Roxywwww/-/实验数据/图片/2026-10-13_HX711排查图片/新HX711实际焊接.jpg

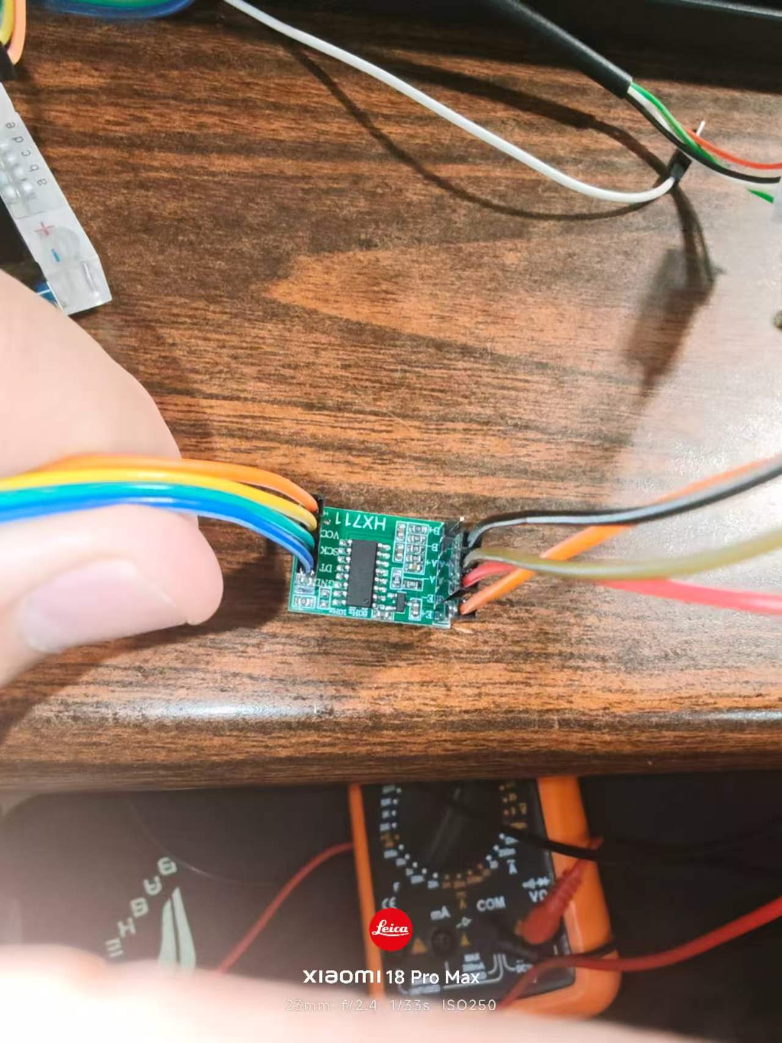
实验数据/图片/2026-10-13_HX711排查图片/新HX711实际焊接.jpg
