Roxywwww/-/实验数据/阶段记录/2026-10-13_20kg传感器与HX711接线排查记录.md

# 20 kg 称重传感器与 HX711 接线排查记录

记录日期：2026-10-13  
用途：毕业设计“硬件调试与故障排查”章节的原始素材。以下是本次实际报告的测量和串口记录；尚未进行去皮、已知质量标定或精度评价。

## 测试背景与初始现象

- 控制器为 STM32F103C8T6；HX711 使用 A 通道、128 倍增益；串口以十进制有符号整数打印 `raw`。
- 本次同时换用了新的 20 kg 称重传感器和 HX711 小板，二者之间有四芯转接头和杜邦线；电压测试时小板 VCC 由 5 V 供电。
- 按商家“10 kg 及以上传感器接线图”，初始连接为白→E+、黑→E−、红→A−、绿→A+。这只是**商家图片标注**，当时尚未验证该只实物的电桥线序。
- 初始空载时串口反复显示 `raw=-8388608`，受力后也没有正常的对应变化。该值是 HX711 有符号 24 位输出的负向极限值，不是质量。

图片证据：[商家接线示意](../图片/2026-10-13_HX711排查图片/商家接线示意.jpg)、[实际焊接](../图片/2026-10-13_HX711排查图片/新HX711实际焊接.jpg)、[四芯转接头](../图片/2026-10-13_HX711排查图片/四芯转接头.jpg)。转接头两侧导线颜色不同，追线时按通断关系确认，不能只看转接线颜色。

## 故障状态下的电压

传感器已连接、未放重物，HX711 小板上电。以下 E+、A+、A− 均以 E− 为黑表笔参考点。

| 测点 | 测量/计算结果 |
|---|---:|
| E− 对 GND | 约 0 V |
| E+ 对 E− | 4.11 V，实测 |
| A− 对 E− | 2.73 V，实测 |
| A+ 对 E− | 1.36 V，实测 |
| A+ 减 A− | −1.37 V，由两次实测计算，非单独实测 |

E+−E− 有 4.11 V 激励，说明并非完全没有传感器供电；A+−A− 却达到约 −1.37 V，远大于正常称重电桥的毫伏级输出，与负向极限 raw 一致。另有 `1.36 V≈4.11 V/3`、`2.73 V≈2×4.11 V/3`，符合把激励加在电桥相邻节点、其余节点处于约 1/3 和 2/3 电位的情况。

## 六组电阻

以下为用户报告的万用表读数。前两组**实际用 20 kΩ 档**，后四组**实际用 2 kΩ 档**；统一换算成 Ω 只是改单位，没有改写测量档位。电阻测量应在断电且传感器与 HX711 分离时进行；本次是否完全断开连接器未单独记录，正式实验应按此条件重测。

| 导线组合 | 原读数 | 换算值 | 实际档位 |
|---|---:|---:|---|
| 白—黑 | 0.24 kΩ | 约 240 Ω | 20 kΩ |
| 红—绿 | 0.29 kΩ | 约 290 Ω | 20 kΩ |
| 白—红 | 0.306 kΩ | 306 Ω | 2 kΩ |
| 白—绿 | 0.343 kΩ | 343 Ω | 2 kΩ |
| 黑—红 | 0.392 kΩ | 392 Ω | 2 kΩ |
| 黑—绿 | 0.257 kΩ | 257 Ω | 2 kΩ |

黑—红与白—绿是互不共线、读数较大的两组。对四臂阻值接近的完整惠斯通电桥，相对节点间的等效电阻通常大于相邻节点间的等效电阻。结合上面的 1/3、2/3 电位关系，推定这只实物更可能以**红—黑为激励对，白—绿为信号对**。实际电桥有修调，电阻不必严格符合四个完全相等电阻的理想模型。

## 接线调整与复测

调试中按红→E+、黑→E−、白→A−、绿→A+ 的目标线序调整转接关系。调整后，串口数据离开负向极限值，空载时约为 3.3 万，受力后升高，卸载后基本恢复。下表从用户发送的连续串口数据中**人工选择稳定段**统计；过渡值未纳入。完整顺序见 [原始串口记录](../原始数据/2026-10-13_20kg传感器接线修正后raw记录.txt)。

| 阶段 | 样本数 | raw 平均值 | 最小值—最大值 | 样本标准差 |
|---|---:|---:|---:|---:|
| 首次空载 | 21 | 33310.5 | 33240—33387 | 37.5 |
| 第一次受力 | 7 | 40502.1 | 40452—40568 | 41.1 |
| 第一次卸载后 | 19 | 33388.5 | 33340—33434 | 30.1 |
| 第二次受力 | 7 | 82118.0 | 82088—82155 | 24.6 |
| 第二次卸载后 | 8 | 33400.3 | 33377—33425 | 15.2 |

两次施力的大小、作用位置和持续时间未记录，不能据此求标定系数、换算克数或评价线性度；恢复值也不与首次空载值完全相同。

## 排查结论与后续补测

故障的直接现象为 HX711 raw 持续处于负向极限。电压测量表明传感器有约 4.11 V 激励，但信号差分约 −1.37 V；六组电阻与 1/3、2/3 电位关系共同提示初始线色分配与实物电桥节点不一致。按推定线序调整后，raw 随施力变化且卸载后基本恢复，完成原始值读取功能验证；**尚未证明质量测量精度**。

正式实验建议补测：①统一在断电、传感器独立状态下用 2 kΩ 档重测六组电阻并记录万用表型号；②量调整后空载 A+−A− 的直流毫伏值；③记录传感器型号、已知质量、安装方式、温度和供电电压；④在相同条件下采集多轮空载/加载/卸载数据。旧 5 kg 传感器数据属于另一套硬件，应单独整理，不与本次 20 kg 数据合并标定。
