Roxywwww/-/实验数据/阶段记录/2026-10-13_20kg传感器空载去皮与串口验证记录.md

# 20 kg 传感器空载去皮与串口验证记录

日期：2026-10-13  
工程：`hx711test`，STM32F103C8T6 + HX711，USART1 115200、8N1  
阶段：原始值稳定读取后的零点去皮；尚未进行质量标定

## 目的与实验条件

在已能读到 HX711 原始值的基础上，验证空载基线，并让程序开机时自动获取去皮零点 `offset`。采集时用户说明秤盘空载。当前机械底盘和最终秤盘结构尚未完成，也没有经其他秤实称的已知质量参考物，因此本次只验证 ADC 计数与去皮，不计算克数或测量精度。

原始串口助手为 COM3，115200、8N1。修改前固件按 `raw=...` 打印十进制有符号 ADC 计数。串口助手接收区取出的连续 120 条数据保存在 [空载原始记录](../原始数据/2026-10-13_空载raw现场采集.txt) 中。软件界面没有提供这些数据的逐条时间戳；固件每次打印后延时 200 ms，但不能据此宣称实际采样间隔严格等于 200 ms。

## 修改内容

仅修改 `hx711test/Core/Src/main.c` 的 `USER CODE` 区域，未改动 CubeMX 自动生成的底层初始化和独立的 HX711 驱动：

1. 上电后先输出 USART1 启动提示，再等待 500 ms。
2. 秤盘保持空载时连续读取 16 次 HX711 转换结果，以其算术平均值作为 `tare_offset`。每次读取仍有 200 ms 的 DOUT 等待超时；遇到超时或 `-8388608`、`8388607` 饱和值，本次去皮判为失败，不使用错误零点。
3. 去皮成功后，串口连续输出 `raw=... net=...`，其中 `net = raw - tare_offset`。`net` 的单位仍是 ADC 计数。去皮失败时保留原始值，并标出 `tare=invalid`。

开机去皮要求秤盘上没有物体；如需重新取零点，可在空载时复位板子。后续按键去皮尚未实现。16 次平均用于减小单次噪声对零点的影响，不等于后续的质量数字滤波。

## 编译与下载

使用 Keil ARMCC V5.06 update 5 编译，结果为 **0 Error(s), 0 Warning(s)**，生成 HEX。通过 Keil/ST-Link 下载，界面显示 `Erase Done`、`Programming Done`、`Verify OK`、`Application running`，Flash Load 完成时间为 21:02:51。串口助手随后显示新格式的 `raw` 与 `net`，说明板上程序运行并持续发出串口数据。

## 数据与结果

| 阶段 | 样本数 | raw 平均值 | raw 最小值～最大值 | 样本标准差 | 备注 |
|---|---:|---:|---:|---:|---|
| 修改前，串口助手接收区末尾空载数据 | 120 | 33295.3 | 33202～33377 | 35.9 | 原始记录见附件 |
| 刷写后，直接读取 COM3 的空载数据 | 50 | 33317.3 | 33267～33397 | 28.7 | 完整记录见附件 |

刷写后的 50 条 `raw,net` 原文保存在 [去皮后串口实测记录](../原始数据/2026-10-13_开机去皮后串口实测.txt) 中，采集完毕后已重新打开串口助手。50 条数据的 `raw - net` 均为 **33283**，据此可核对该次开机的 `tare_offset=33283`。该组 `net` 的平均值为 **+34.3 计数**，范围 **-16～+114 计数**，样本标准差 **28.7 计数**。数据直接来自串口输出，未人工修改或补造。该文件也没有逐条时间戳。

空载 `net` 并非每条都严格为零，因为 `offset` 是开机时 16 次采样的平均值，后续瞬时 ADC 读数会受噪声、机械状态和零点变化影响。前后两组空载数据不是同一时刻采集，不能仅凭它们评估长期零漂或温度影响。

## 可用于论文的阶段性表述

在完成传感器接线排查后，系统通过 STM32F103C8T6 读取 HX711 的 24 位有符号原始数据，并由 USART1 输出。对空载状态下采集的 120 个原始计数进行统计，均值为 33295.3，样本标准差为 35.9。随后在程序中加入开机去皮：对 16 次有效转换结果求平均，作为零点偏移量，再从后续原始计数中减去该偏移量。固件经 Keil 编译无错误、无警告，并通过 ST-Link 下载校验。刷写后连续采集的 50 组串口数据中，`raw-net` 恒为 33283，验证了去皮运算和串口输出的一致性。本阶段尚无已知质量参考物，故数据仅用于验证原始采集与零点处理，不能用于计算克数、标定系数或测量精度。

## 下一步

完成最终机械安装后，在空载条件下重新采集零点；准备至少一件经可信秤称量的已知质量物品，再测得该载荷的稳定 `net`，计算每克 ADC 计数 `scale=(raw_参考-offset)/质量_g`，随后才能使用 `质量_g=net/scale`。继续记录参考物质量、放置位置、加载/卸载次数、原始数据和环境条件，以便评估重复性及误差。
