Roxywwww/-/实验数据/阶段记录/2026-10-15_5点滑动平均滤波开发与实测记录.md

# 5 点滑动平均滤波开发与实测记录

日期：2026-10-15（北京时间）  
工程：`hx711test`，STM32F103C8T6 + HX711，USART1/COM4，115200、8N1  
阶段：完成基本数字滤波；尚未加入 OLED 或温度补偿

## 目的与实现

前一阶段已能经串口输出 `raw/net/g`，但同一载荷下各次 `g` 会随 ADC 噪声和机械状态上下跳动。本次在 [`main.c` 的 USER CODE 区域](../../hx711test/Core/Src/main.c)加入 **5 点滑动平均**，串口保留原有 `raw/net/g`，新增 `g_avg` 以直接比较滤波前后。没有改动 CubeMX 自动生成的初始化、`.ioc` 配置和 HX711 独立驱动；标定系数仍为前一阶段的暂定值 **177.6184 计数/g**。

每次取得有效读数后，先计算 `net = raw - tare_offset`。使用长度为 5 的循环数组存储最近 5 次 `net`，并维护它们的和：新读数加入，数组满时同时扣除被覆盖的旧读数。用和除以当前有效样本数（最初 1～4 次也只除以已有数目），得到 `average_net`，然后按同一系数换算为保留一位小数的 `g_avg`。因此，最初几次不会因为数组初值为零而把显示拉向零。

开机去皮和 PA5 按键去皮成功后均清空滤波状态，以免新的 offset 混入去皮前的旧 `net`。去皮失败不更换 offset，也不清空原滤波状态。主循环约每 200 ms 报告一次，5 个读数约跨越 0.8 s；这是固件报告周期，不代表 HX711 严格等间隔转换。`g_avg` 只是平滑显示，未修改 `raw`、`net` 或瞬时 `g`，也不能消除零点漂移和标定误差。

## 编译与下载

Keil ARMCC V5.06 update 5 编译结果：**0 Error(s), 0 Warning(s)**，生成 HEX；[编译日志](<../构建日志/MDK-ARM/build_filter.log>)。通过 Keil/ST-Link 下载，日志显示 `Erase Done`、`Programming Done`、`Verify OK` 和 `Application running`，完成时间 18:49:33；[下载日志](<../构建日志/MDK-ARM/flash_filter.log>)。随后直接从 COM4 采集到新格式 `raw=... net=... g=... g_avg=...`。

## 实测原始数据与统计

用户确认秤盘空载后下载固件。此后按“空载稳定 → 用户放置标称 500 g → 500 g 稳定 → 连续记录期间用户卸载 500 g → 空载按键去皮”的顺序测量。数据均直接来自 COM4，电脑在收到完整串口行时附上本地时间戳；它不是 ADC 转换时刻。原始记录如下：

1. [空载稳定 100 行 CSV](../原始数据/2026-10-15_5点滑动平均_空载实测.csv)
2. [标称 500 g 稳定 100 行 CSV](../原始数据/2026-10-15_5点滑动平均_500g稳定实测.csv)
3. [500 g 卸载动态 144 行 CSV](../原始数据/2026-10-15_5点滑动平均_500g卸载动态实测.csv)
4. [按键去皮动态串口原文 87 行](../原始数据/2026-10-15_5点滑动平均_按键去皮动态串口原文.txt)

前三份 CSV 的列为 `timestamp_local,raw,net,g,g_avg`。样本标准差使用分母 `n-1`；同一组的两列标准差可比较显示波动，但**不能据此宣称绝对测量精度**。

| 状态与统计段 | 行数 | 瞬时 `g` 均值 | 瞬时 `g` 样本标准差 | `g_avg` 均值 | `g_avg` 样本标准差 | `raw-net` |
|---|---:|---:|---:|---:|---:|---:|
| 空载稳定 | 100 | +0.119 g | 0.156 g | +0.122 g | 0.087 g | 33538 |
| 500 g 稳定 | 100 | 500.672 g | 0.154 g | 500.667 g | 0.087 g | 33538 |
| 卸载动态：前 60 行、尚未卸载 | 60 | 500.677 g | 0.166 g | 500.667 g | 0.122 g | 33538 |
| 卸载动态：最后 50 行、已空载 | 50 | +0.512 g | 0.170 g | +0.518 g | 0.121 g | 33538 |

在两段独立采集的稳定组中，5 点平均后的样本标准差约为瞬时读数的 **56%**，表明这次短时显示波动有所减小。500 g 均值略高于标称值、卸载后空载均值仍约 +0.5 g，提示零点和机械状态在变化；滤波只降低短时抖动，不能代替重新去皮、标定或机械固定。本次 500 g 砝码正是前一阶段用于求系数的标称参考物，不能把此结果当作独立准确度检定。

## 卸载响应与按键去皮

卸载动态 CSV 的第 85 行（电脑接收时间 18:52:16.044）中，瞬时 `g` 已降至 **0.3 g**，而 `g_avg` 仍为 **367.1 g**。第 89 行（18:52:16.850）`g_avg` 才降至 **0.5 g**。按串口接收时间计算，滤波输出比瞬时读数约晚 **0.806 s** 接近空载；这是一次卸载过程的观察，不是完整响应时间指标。动态记录中可由连续 5 行 `net` 独立核对的 140 行，`g_avg` 与固件滑动平均结果全部一致。

用户随后在空载时短按 PA5。串口原文记录到 `tare_button_offset=33589`（18:53:13.336），原 offset 为 33538；去皮后首条输出为 `raw=33590 net=1 g=0.0 g_avg=0.0`。去皮后的 12 条完整读数均满足 `raw-net=33589`，并且以新读数从 1 条累积到最多 5 条计算出的 `g_avg` 与串口一致，验证了按键去皮后滤波窗口清空。串口原文按采集顺序保留。

## 可用于论文的阶段性表述

在已有质量换算程序基础上，引入长度为 5 的滑动平均滤波，以循环数组保存最近 5 次去皮后 ADC 计数，并维护窗口和；每次读取后输出瞬时质量和滤波后质量。空载及标称 500 g 稳定状态各采集 100 组串口数据，瞬时质量的样本标准差分别为 0.156 g、0.154 g，滤波后分别降为 0.087 g、0.087 g。连续记录的卸载过程中，滤波结果比瞬时读数约晚 0.806 s 接近空载，体现了平滑程度与响应速度之间的取舍。按键重新去皮后，滤波窗口清空并使用新零点，串口后续 12 条数据均与重新累计的滑动平均计算一致。本阶段数据来自临时机械安装状态，仅用于验证滤波功能和观察显示波动，不代表全量程精度或温度补偿效果。

## 下一步

先保持 `raw/net/g/g_avg` 并观察日常使用时的响应是否合适；若 0.8 s 左右的卸载延迟影响操作，再在相同条件下比较 3 点等更短窗口。基础滤波验证通过后，才进入 OLED 软件 I2C 显示。最终秤盘及 PCB 安装完成后应重新去皮、标定，再评价系统误差。
