Roxywwww/-/实验数据/阶段记录/2026-10-15_OLED软件I2C移植与称重显示实测记录.md

# OLED 软件 I²C 移植与称重显示实测记录

日期：2026-10-15（北京时间）  
工程：`hx711test`，STM32F103C8T6 + HX711 + 0.96 英寸四针 OLED  
阶段：在已有 `raw → 去皮 → 克数换算 → 五次移动平均` 基础上，增加 OLED 显示

## 参考资料与接线

参考用户提供的 `C:\baidunetdiskdownload\STM32入门教程资料\程序源码\STM32Project-无注释版\4-1 OLED显示屏` 标准库示例，以及 `模块资料\8-OLED显示屏` 中的 OLED 模块资料。示例使用 GPIO 软件模拟 I²C、128×64 OLED、8×16 ASCII 字库；本次保持其 SSD1306 初始化命令、字符写入方法和设备地址字节 `0x78`，将 GPIO 操作换为 HAL API。`0x78` 是包含写方向位的 8 位地址字节，对应 7 位 I²C 地址 `0x3C`。

用户确认模块为 GND/VCC/SCL/SDA 四针，VCC 接 3.3 V，接线按示例：PB8→SCL、PB9→SDA，GND 共地。PB8、PB9 在 CubeMX `.ioc` 中配置为开漏输出、高速、初始高电平，软件 I²C 的空闲状态 SCL/SDA 均为高电平。HX711 PB12/PB13、PA5 去皮键和 USART1 配置保持原有功能。

## 实现步骤

1. 从示例移植字库和 `OLED.c/.h` 到工程 `Core`，驱动中使用 `HAL_GPIO_WritePin`、`HAL_GPIO_Init` 和 `HAL_Delay`。显示字符限定在 4 行×16 列范围内。Keil 工程加入 `oled.c`。
2. 第一版只显示 `OLED HAL OK`、`PB8 SCL PB9 SDA`、`I2C 0x3C`。Keil 编译 **0 Error(s), 0 Warning(s)**；下载日志显示 `Programming Done`、`Verify OK`。用户目视确认三行文字清楚显示，证明接线、软件 I²C、初始化和字符显示可工作。
3. 第二版显示 `WEIGHT (g)`、五次移动平均值 `g_avg`、`AVG 5 SAMPLES` 和 `PA5 TARE`。第 2 行每约 500 ms 重画一次，固定写满 16 个字符，以空格覆盖上一次读数遗留的数字；串口仍约每 200 ms 打印 `raw/net/g/g_avg`。屏幕和串口都用同一份 `average_tenths` 换算结果，负值也保留。第 2 次编译同样 **0 Error(s), 0 Warning(s)**，下载验证成功。

代码与日志：[main.c](../../hx711test/Core/Src/main.c)、[oled.c](../../hx711test/Core/Src/oled.c)、[oled.h](../../hx711test/Core/Inc/oled.h)、[字库](../../hx711test/Core/Inc/OLED_Font.h)、[CubeMX 配置](../../hx711test/hx711test.ioc)、[静态版编译日志](<../构建日志/MDK-ARM/build_oled_stage1.log>)、[静态版下载日志](<../构建日志/MDK-ARM/flash_oled_stage1.log>)、[动态版编译日志](<../构建日志/MDK-ARM/build_oled_weight.log>)、[动态版下载日志](<../构建日志/MDK-ARM/flash_oled_weight.log>)。

## 实测方法与原始记录

动态版下载时秤盘空载，用户目视确认 OLED 显示接近 0 g 且数值更新。电脑通过 COM4、115200、8N1 直接采集串口；每组等待状态稳定后抓取约 8 秒。计算表中的均值是对串口所打印数值求算术平均，未修改原始行。每一组文件保留 `raw/net/g/g_avg` 原文：

| 顺序 | 状态 | 原始记录 | 完整行数 | `raw` 均值 | `g_avg` 均值 | `g_avg` 范围 |
|---|---|---|---:|---:|---:|---:|
| 1 | 标称 500 g 砝码置于秤盘中央 | [500 g 串口原文](../原始数据/2026-10-15_OLED阶段_500g串口实测原文.txt) | 40 | 122246.85 | 500.60 g | 500.4～500.8 g |
| 2 | 取走砝码后空载 | [首次卸载空载原文](../原始数据/2026-10-15_OLED阶段_卸载空载串口实测原文.txt) | 39 | 33383.74 | 0.28 g | 0.1～0.4 g |
| 3 | 继续保持空载，不重新去皮 | [延时空载原文](../原始数据/2026-10-15_OLED阶段_卸载后延时空载串口实测原文.txt) | 40 | 33428.22 | 0.56 g | 0.4～0.7 g |
| 4 | 空载短按 PA5 去皮后 | [按键去皮后空载原文](../原始数据/2026-10-15_OLED阶段_按键去皮后空载串口实测原文.txt) | 40 | 33400.32 | 0.01 g | -0.2～0.2 g |

500 g 组串口 `g` 均值为 500.60 g、范围 500.3～500.9 g；用户目视 OLED 约显示 500.5 g，随串口轻微变化。卸载后用户看到 OLED 约 0.5 g；随后的第三组串口也测得 `g_avg` 均值 0.56 g，说明屏幕反映了传感器/换算链路的实际读数，并非 OLED 特有的显示错误。第三组沿用开机去皮的 `tare_offset=33330`；按键去皮后，第四组 40 行均满足 `raw-net=33396`，证明零点更新。用户目视确认屏幕随后回到 0.0 g 附近。

卸载后读数从首次约 0.28 g 上移到稍后约 0.56 g，是本轮应保留的**回零偏差观测**。目前无法单凭这些数据判定原因；可能涉及秤梁机械回弹、临时安装受力、供电或零点漂移。没有同步测量温度、供电电压或平台受力状态，因此不能写成温度漂移结论。标称 500 g 未经其他仪器实称，且当前标定系数来自面包板阶段；显示 0.1 g 步进不等于系统准确度达到 0.1 g。正式固定秤盘/底座和 PCB 后应重新标定，并做重复加载、卸载及多点误差试验。

## 当前结论与下一步

OLED 的四针接线、HAL 软件 I²C 驱动、字符显示、克数实时显示和 PA5 去皮后的屏幕更新均已在实物上验证。下一步可在当前临时结构上先做长时间空载漂移观察；最终机械结构定型后再做准确度和温度实验。
