Roxywwww/-/实验数据/阶段记录/2026-10-15_串口克数输出开发与砝码复测记录.md

# 串口克数输出开发与砝码复测记录

日期：2026-10-15（北京时间）  
工程：`hx711test`，STM32F103C8T6 + HX711，USART1/COM4，115200、8N1  
阶段：由 `raw/net` 扩展为 `raw/net/g`；尚未加入数字滤波或 OLED

## 本次目标与代码修改

前一轮以标称 500 g 砝码和空载数据求得初步系数 **177.6184 ADC 计数/g**，详见 [100～800 g 砝码标定与零点复测记录](2026-10-15_100至800g砝码标定与零点复测记录.md)。本次只在 [`main.c` 的 USER CODE 区域](../../hx711test/Core/Src/main.c)增加换算和串口输出，未修改 CubeMX 自动生成的初始化、HX711 独立驱动或 `.ioc` 配置。

运行时仍由开机或 PA5 按键去皮采样确定当前 `tare_offset`，然后计算 `net = raw - tare_offset`。`net` 的单位是 ADC 计数；`g = net / 177.6184`。为避免 Keil 的 `printf` 浮点格式化配置影响输出，固件以 64 位整数中间值计算并四舍五入到 **0.1 g**，串口格式变为 `raw=... net=... g=...`。负的 `net` 也按相同规则处理，保留负数以便观察零点变化；没有把接近零的读数强制改成 0。

系数是当前面包板/临时机械安装状态下的初步结果，不能写死为最终系统的检定系数。重新安装秤盘、底座或改变供电和接线后，应重新标定。显示到 0.1 g 是输出步进，不等同于系统精度达到 0.1 g。

## 编译、下载与串口占用

用 Keil ARMCC V5.06 update 5 编译，结果为 **0 Error(s), 0 Warning(s)**，HEX 已生成；[编译日志](<../构建日志/MDK-ARM/build_grams.log>)。通过 Keil/ST-Link 下载，日志显示 `Erase Done`、`Programming Done`、`Verify OK`、`Application running`，完成时间 18:36:02；[下载日志](<../构建日志/MDK-ARM/flash_grams.log>)。随后直接采到新格式的 `raw/net/g`，证明板上运行了本次固件。

用户反馈串口助手接收区积累太多文本后卡顿并重启。为避免继续积累，本次后续测量由电脑暂时独占 COM4，串口助手保持关闭端口。第一次准备测 500 g 时 COM4 又被串口助手占用，打开失败，**当时没有取得样本**；暂停串口助手接收后重新采集成功，保存的 500 g CSV 是成功重采的 60 行。直接打开串口时可能从一行的中间开始，按键去皮后的空载采集中出现过一条不完整串口行，因不符合完整 `raw/net/g` 格式，未计入 60 条有效数据。

## 操作顺序与原始数据

1. 下载固件后保持空载，采 80 行：[开机后空载 CSV](../原始数据/2026-10-15_克数固件_空载实测.csv)。
2. 用户在空载状态短按并松开 PA5 去皮键，采 60 行：[按键去皮后空载 CSV](../原始数据/2026-10-15_克数固件_按键去皮后空载实测.csv)。
3. 用户放标称 500 g 砝码，采 60 行：[500 g CSV](../原始数据/2026-10-15_克数固件_500g实测.csv)。
4. 用户再加标称 200 g 和 100 g，合计 800 g，采 60 行：[800 g CSV](../原始数据/2026-10-15_克数固件_800g实测.csv)。
5. 用户拿走 500 g 和 200 g，只留标称 100 g，采 60 行：[100 g CSV](../原始数据/2026-10-15_克数固件_100g实测.csv)。
6. 用户拿走最后的 100 g，不再去皮，采 60 行：[终点空载 CSV](../原始数据/2026-10-15_克数固件_终点空载实测.csv)。

CSV 共 **380 条完整数据行**，每行含电脑接收时生成的本地时间戳以及串口解析出的 `raw,net,g`。这些时间戳不是 HX711 转换完成时刻。所有 380 行均已核对：`raw-net` 与该阶段 offset 一致，且 `g` 与 `net/177.6184` 四舍五入到 0.1 g 的结果一致。没有对 CSV 的数值进行平滑、补造或事后修改。用户提供砝码的标称质量，实际质量未由其他仪器核验；供电电压、温度和摆放偏心量本轮未同步记录。

## 实测结果

样本标准差以 `n-1` 为分母。表内 `g` 均值是 **串口所打印值的均值**，不是再拿 `raw` 均值重新四舍五入。

| 状态 | 行数 | `raw` 均值 | `raw` 样本标准差 | `g` 均值 | `g` 范围 | `raw-net` |
|---|---:|---:|---:|---:|---:|---:|
| 开机后空载 | 80 | 33585.09 | 29.27 | +0.399 g | 0.0～0.8 g | 33514 |
| 按键去皮后空载 | 60 | 33553.37 | 27.16 | +0.075 g | -0.2～0.4 g | 33539 |
| 标称 500 g | 60 | 122381.23 | 25.47 | 500.187 g | 499.9～500.6 g | 33539 |
| 标称 800 g | 60 | 175727.30 | 31.28 | 800.537 g | 800.2～801.0 g | 33539 |
| 标称 100 g | 60 | 51307.68 | 27.96 | 100.037 g | 99.6～100.4 g | 33539 |
| 卸载后空载 | 60 | 33522.15 | 26.52 | -0.093 g | -0.5～0.2 g | 33539 |

按键后 `raw-net` 从 **33514** 变为 **33539**，此后各组始终保持 33539，证明新去皮零点被用于后续换算。按键后的空载均值约 +0.075 g，经过 500→800→100 g 加载与卸载，终点空载均值约 -0.093 g；两组 `raw` 均值相差 **-31.22 计数**，按本次系数约为 **-0.176 g**。这些观测值不表示温漂结论，因为本次未同步测温，且机械回弹、放置和供电等影响尚未分离。

500 g 是求取初步系数时所用的标称砝码，因此再次显示接近 500 g 主要验证了固件换算与去皮功能，不能算独立的准确度验证。100 g 和 800 g 沿用同一系数，显示均值与标称值分别相差约 **+0.037 g** 和 **+0.537 g**；它们是本轮搭建和操作条件下的结果，不能外推到 10 kg 或 20 kg 量程。

## 可用于论文的阶段性表述

在完成 HX711 原始数据读取和去皮后，将先前以标称 500 g 参考物求得的 177.6184 计数/g 初步系数写入 STM32 程序，实现 `raw`、扣零后的 `net` 及质量估计 `g` 同步串口输出。Keil 编译无错误、无警告，ST-Link 下载校验通过。用户依次施加标称 500、800、100 g 载荷并卸载，每个状态直接记录 60 条带电脑接收时间戳的串口数据；串口输出的质量均值分别为 500.187、800.537、100.037 g，终点空载均值为 -0.093 g。按键去皮后，各组 `raw-net` 恒为 33539，说明去皮零点被持续应用。由于参考砝码实际质量、环境温度和最终机械安装尚未独立确认，该实验只验证当前原型的克数换算及加载/卸载功能，不构成全量程精度评价。

## 下一步

先处理串口助手长时间积累文本造成的卡顿，或改用可保存日志且接收区容量受控的工具。随后在相同机械条件下评估基础数字滤波的效果；OLED 显示再使用经过验证的 `g` 值。最终底盘与秤盘安装完成后，重新采集零点和比例系数，并补充目标工作范围内多个可信参考载荷的重复加载、卸载试验。
