Roxywwww/-/实验数据/阶段记录/2026-10-18_DS18B20单总线温度读取开发与验证记录.md

# DS18B20 单总线温度读取开发与验证记录（2026-10-18）

## 本阶段目的与接线

在现有 STM32F103C8T6 + HX711 + OLED 称重工程中，只增加 DS18B20 温度采集与显示，不加入温度补偿。用户说明 DQ 接 PA12；方案采用三线供电：VDD 接 3.3 V、GND 接公共地、DQ 经约 4.7 kΩ 电阻上拉至 3.3 V，同时直连 PA12。**电阻的实际安装及引脚方向仍以下载前用户确认和后续实测为准。**PA12 复用 USB D+，但当前工程未启用 USB。

## 实现方法

- CubeMX 配置文件 `hx711test.ioc` 增加 PA12，设为开漏输出、初始释放为高电平；1-Wire 的“拉低”由 STM32 驱动，“高电平”由外部电阻提供。
- 独立驱动文件 `Core/Src/ds18b20.c`、`Core/Inc/ds18b20.h` 实现复位与存在脉冲、LSB 先行的读写时隙、`SKIP ROM`、`CONVERT T`、读取 9 字节暂存器及 CRC8 校验。单总线微秒延时由 Cortex-M3 的 DWT 周期计数器实现，关键时隙暂时屏蔽中断。
- 主循环发起转换后继续运行 HX711 称重，至少等 800 ms 再读取温度；串口另起 `temp_c=...` 行，不改变既有 `raw/net/g/g_avg` 行。OLED 第 3 行显示温度。若缺失存在脉冲或读数/CRC 异常，串口输出 `temp_error=...`，OLED 显示错误；不把异常读数显示成有效温度。
- 这里只读取温度，不把温度值用于重量计算；温漂补偿参数须在机械结构和 PCB 固定后通过分温度实验确定。

时序、转换命令及 CRC 数据结构参考 [DS18B20 官方数据手册](https://www.analog.com/media/en/technical-documentation/data-sheets/ds18b20.pdf)。

## 工程修改与当前验证结果

修改文件：`hx711test.ioc`、`Core/Inc/main.h`、`Core/Src/main.c`、`Core/Inc/ds18b20.h`、`Core/Src/ds18b20.c`、`MDK-ARM/hx711test.uvprojx`。现有 HX711、OLED、PA5 去皮逻辑保留。

Keil ARMCC V5.06 update 5 已完成编译，生成 HEX，结果为 **0 Error(s), 0 Warning(s)**。编译日志：[`build_ds18b20.log`](<../构建日志/MDK-ARM/build_ds18b20.log>)。

用户确认秤盘空载、DS18B20 DQ 经约 4.7 kΩ 上拉至 3.3 V 并接 PA12 后，通过 Keil/ST-Link 下载，日志显示 `Erase Done`、`Programming Done`、`Verify OK`、`Application running`，时间 17:55:30。下载日志：[`flash_ds18b20.log`](<../构建日志/MDK-ARM/flash_ds18b20.log>)。

## 串口与 OLED 实物验证

重插连接后系统仍只枚举出 COM4。普通运行权限下尝试打开 COM4 返回“Access denied”，提升本机串口访问权限后可以正常打开并读取；因此不能据此判断串口助手一定占用了端口。电脑于 17:57:24～17:57:38 从 COM4（115200、8N1）采集 15 秒，原样保存 87 行串口数据及电脑收到完整行时的本地时间戳：[`2026-10-18_DS18B20_串口原始数据.csv`](../原始数据/2026-10-18_DS18B20_串口原始数据.csv)。电脑时间戳不是传感器内部转换时刻。

87 行均能按预期格式解析：`temp_c` 17 行，`raw/net/g/g_avg` 70 行，没有 `temp_error` 行。温度第一条为 **27.68 °C**，最后一条为 **26.68 °C**，期间缓慢下降；本组温度均值 27.069 °C。此变化可能与传感器此前被手触碰或环境温度变化有关，尚未进行独立温度计比对，因此不能当作温度准确度结论。称重的 `net` 平均值为 2.4 counts、范围 -55～63 counts；`g_avg` 范围 -0.2～0.2 g。这里仅说明温度读取与称重输出能够并行持续运行，不能作为最终秤量精度数据。

用户目视确认 OLED 第 3 行温度持续更新，重量显示也正常。由此完成了本阶段“读温度、串口输出、OLED 显示”的功能验证。

随后用户实际拔下温度传感器连接，反馈 OLED 显示 `TEMP ERROR`。这是**用户目视观察到的断线错误显示验证**；本次未同步抓取拔下后的串口原始行，也未分别测试 DQ、VDD、GND 单线断开，不能据此区分全部故障类型。错误 CRC、温度标准器比对及温度补偿实验仍未进行。仅在代码中关闭温度读取不构成断线测试。

## 下一阶段结构方案（待设计）

用户拟将 DS18B20 作为外置探头，三根线焊在传感器上，再接至 PCB；HX711、OLED、按键等优先通过接插件连接，以减少直接焊线。PCB 应提供 DS18B20 的 3.3 V、DQ、GND 接口，并在 DQ 与 3.3 V 之间放置约 4.7 kΩ 上拉电阻。温度探头的固定位置应靠近称重梁且保持一致，作为后续温漂实验的测温位置；具体线长、连接器与机械固定方式尚未确定。
