Roxywwww/-/实验数据/阶段记录/2026-10-22_HX711模块6P4P插座定位记录.md

# HX711 小模块 6P／4P 插座定位记录

日期：2026-10-22

## 本次目标与依据

在已有嘉立创 EDA Pro 底板 PCB 上，定位可拔插的 HX711 小模块两排母座，暂不布线。用户实物及资料包封面图显示：模块一侧为 6 针（E+、E−、A−、A+、B−、B+），另一侧为 4 针（GND、DT、SCK、VCC）。4 针排与 6 针排的第 2～5 针相对齐。

公开商品资料对相似的 XFW-HX711 小模块分别给出 **24 × 15.5 × 2.7 mm** 与 **25 × 16 × 3.2 mm** 的外形，说明外形存在版本差异。这些页面没有给出本块实物的两排孔中心距。依据本地 `C:\baidunetdiskdownload\A1-3-4C\封面图.jpg`，以已知的同排 2.54 mm 孔距作比例估算，两排孔中心距约 20.4 mm；PCB 暂采用 20.32 mm（800 mil）。**20.32 mm 是照片推算值，未经过实物卡尺验证，不是厂家标称尺寸。**

公开资料：

- WAVGAT mini HX711 商品页：https://wavgat.com/product/hx711-mini-load-cell-amplifier-module-24-bit-adc-dual-channel-weight-sensor-board-10hz-80hz-switchable/
- XFW-HX711 商品页：https://shop.cpu.com.tw/product/56384/info/

## 当前 PCB 设置

| 插座 | 中心 X | 中心 Y | 角度 | 从 PCB 顶视图上到下 |
| --- | ---: | ---: | ---: | --- |
| HX711-6P | 48.00 mm | −28.00 mm | 270° | 1 E+、2 E−、3 A−、4 A+、5 B−、6 B+ |
| HX711-4P | 68.32 mm | −28.00 mm | 90° | 4 GND、3 DT、2 SCK、1 VCC |

两排中心 X 相差 20.32 mm，同排孔距采用 2.54 mm。4P 的 4、3、2、1 号焊盘依次与 6P 的 2、3、4、5 号焊盘等高。元件目前位于左上部、称重信号接头上方；未修改其他元件和电气连线。嘉立创 EDA Pro 界面显示保存成功。

## 制板前必须核对

1. 用卡尺量本人 HX711 模块的两排**孔中心到孔中心**距离；若不等于 20.32 mm，先修改 4P 的 X 坐标（以 6P 的 X=48.00 mm 为基准）。
2. 核对 4P 相对 6P 的纵向错位方向、针脚号和母座朝向；最好从 EDA 按 **100% 实际尺寸**打印纸样，把焊好排针的模块试插到纸样上。
3. 检查母座焊后模块底部元件与 PCB、周边元件的机械间隙，再布线与下单。当前布局是待实物验证的定位稿，不能仅凭外形尺寸直接投板。

本记录是 PCB 结构与尺寸设计过程记录，可用于论文的硬件设计、模块化接口与尺寸核验章节；不把照片估值写成实测值。

## 2026-10-23 纸样试放复核

已按 PDF 第 4 页打印 PCB 顶视纸样，将焊有 6P 与 4P 排针的 HX711 小板放在对应区域，并拍摄斜上、六针侧、低角度侧视三张照片，保存在 `2026-10-23_HX711纸样试插图片/`。照片说明模块外形和两排插座的总体方向相符，提供了布局试放的过程证据。

**本次照片还不足以判定 20.32 mm 两排孔距已经验证通过。** 排针未真正插入纸孔；斜拍存在透视和模块离纸高度造成的视差，无法从照片确认 6P 与 4P 的所有针尖是否同时落在各自印刷孔中心。也未记录打印后板框的实际尺量值，故不能据此确认 PDF 输出为 100% 比例。

用户在现场从实物观察后反馈：**两排排针与纸样孔位基本对齐**。因此本次纸样试放的目视初筛通过；结论依据为现场目视观察，不等同于卡尺测得 20.32 mm，也不等同于实际 PCB 母座试插通过。

下一次复核：先量纸上板框，应为 110 × 70 mm；把纸贴在平面，从正上方分别核对两排针尖的位置，最好量实物两排针**中心到中心**距离，记录数值与量具。若实物与 20.32 mm 不符，修正 PCB 后重新打印。制板前还需确认模块插入母座时的高度和周边净空。
