Roxywwww/-/实验数据/阶段记录/2026-10-23_HX711供电条件更正与第二按键方案.md

# 2026-10-23 HX711 供电条件更正与第二按键方案

本条是设计与实验条件记录，不是新增称重实测数据。

## 供电条件更正

- 用户复查面包板后发现，HX711 模块曾因重新插接在 3.3 V 与 5 V 之间切换，无法逐次确认此前所有称重记录对应的模块供电。
- 早期曾测得 HX711 的 E+ 约 4.11 V，这能支持**该次测量**处于较高供电状态，但不能据此把全部历史数据标记为 5 V。
- 历史原始数据与已算出的标定系数保留原值，供电条件统一注明“未逐次确认”；不得把不同供电条件下的标定结果直接视为可复现的统一数据集。
- 用户决定控制 PCB 的 HX711 模块供电按 5 V 规划。2026-10-22 原理图第二轮截图记录显示，HX711 四针接口的 VCC 已标为 5V。下单前仍应复核最新原理图、网表和实物引脚。
- HX711 数据手册建议 DVDD 与 MCU 数字电源相同。当前 STM32 核心运行在 3.3 V，HX711 模块 VCC 计划接 5 V，因此须在定稿前核实模块的 DVDD 实际连接以及 PB12→PD_SCK、DOUT→PB13 的电平兼容性；既往通信成功只能证明当时的实物组合可工作，不能代替规格核对。
- PCB 装好、供电固定为 5 V 后，应重新进行空载零点、已知砝码标定和误差测试，并记录每次测试的供电、砝码、温度、装配状态。

## 第二按键预留方案

- 现有 PA5 按键继续只做去皮。
- 新按键建议短按切换显示单位 g/kg，满足任务书中的单位切换要求。显示单位改变不应改动 raw、offset 或 scale，也不应触发新标定。
- 建议预留 PB15—常开按键—GND，固件将 PB15 配为上拉输入，按下读到低电平，并做消抖。PCB 可选板载按钮或两针外接按钮接口，依实际安装位置定封装。
- 校准保留为有明确砝码和操作流程的功能，不与普通单位切换短按混用；目前尚未修改固件或 .ioc。

## 资料依据

- AVIA Semiconductor, *HX711 24-Bit ADC for Weigh Scales*, V2.0：DVDD 建议与 MCU 电源相同，PD_SCK 为数字输入，DOUT 为数字输出。<https://e2e.ti.com/cfs-file/__key/communityserver-discussions-components-files/73/HX711.pdf>
- STMicroelectronics, *STM32F103x8/xB datasheet*, DS5319：PB12、PB13、PB15 的引脚类型与复用信息。<https://www.st.com/resource/en/datasheet/stm32f103c8.pdf>
