Roxywwww/-/实验数据/阶段记录/2026-10-24_PA3单位切换与PCB同步记录.md

# 2026-10-24 单位切换按键改用 PA3 与 PCB 同步

本记录接续《2026-10-24_PA4单位切换与PCB接线核对.md》。因面包板上 PA4 与 PA5 接线过近，单位切换按键改接 PA3；此前文件中的 PA4 接法和“尚未下载”状态以本记录为准予以更正。本次没有采集砝码读数，不构成精度实验结果。

## 固件与下载

- `hx711test.ioc` 将 `UNIT_BUTTON` 配置由 PA4 改为 PA3，保持 GPIO 上拉输入；按键另一端接 GND，按下时为低电平。
- `Core/Inc/main.h` 改为 `GPIO_PIN_3`；`Core/Src/main.c` 的 OLED 接线提示改为 `PA5 TARE A3 UNIT`。原有消抖及 g/kg 切换逻辑沿用。
- Keil MDK 重新构建：0 errors、0 warnings，生成 HEX。ST-Link 下载日志显示 `Erase Done.Programming Done.Verify OK.Application running`，时间为 2026-10-24 11:22:35。
- 下载时秤盘由使用者确认为空载。PA3 实物按键尚未按压验证，不能据此声称 g/kg 切换已通过现场测试。

## 嘉立创 EDA 原理图与 PCB

- 原理图中 g/kg 切换按钮 1 脚网络标签由 `A4` 改为 `A3`，2 脚仍为 `GND`，并保存。
- PCB 同步后，查看按钮 1 脚焊盘属性，其网络为 `A3`；可见走线由核心板插座 H2 的 A3 焊盘接到该按钮 1 脚。原 PA4 焊盘未接此按钮。PCB 已保存。
- 重新运行 PCB DRC：仍有 8 项连接性错误，**全部属于 GND 网络**，与此前一致；没有新增 A3 未连接报错。该结果只说明当前网络连接性，不代替实际铜线间距、焊盘方向和实物试插核对。

## 地网与后续检查

可在 PCB 的顶层或底层建立网络指定为 `GND` 的铺铜区域，包围需要相连的地焊盘；重新填充后再次运行 PCB DRC。通孔焊盘可与两面铜层连接，但如果铺铜形成孤岛、被其他走线隔开或没有接到核心板 GND，仍需用 GND 走线或过孔连接。以 DRC 的 GND 连接性错误归零为完成依据。

面包板测试时将单位按钮信号线移到 PA3、另一端接 GND；观察短按只切换一次、松开再按能切回，且 PA5 去皮独立有效。上述实物测试尚待完成。
