Roxywwww/-/实验数据/阶段记录/2026-10-24_PA4单位切换与PCB接线核对.md

# 2026-10-24 PA4 单位切换与 PCB 接线核对

本记录包含代码进度和嘉立创 EDA 实时图纸检查结果。未进行新砝码实验或实物按键验证，不应作为称重精度数据。

## 固件进度

- 在 `hx711test.ioc` 中增加 PA4 GPIO 上拉输入，标签 `UNIT_BUTTON`；按键一端接 PA4，另一端接 GND，按下读到低电平。
- 在 `main.c` 中加入 30 ms 消抖和松开后才能再次触发的逻辑。每次有效按下只切换一次 g/kg。开机默认 g，切换不会改变 HX711 原始值、去皮 offset、标定系数或滤波缓冲区。
- OLED 第二行在 g 模式显示 0.1 g 位，在 kg 模式显示 0.0001 kg 位；两者是同一重量数据的单位换算。串口原有 `raw/net/g/g_avg` 调试格式保持，切换时额外输出 `display_unit=g` 或 `display_unit=kg`。
- Keil MDK 编译：0 errors、0 warnings；生成新的 `.axf` 和 `.hex`。尚未下载或完成按键实物测试。

## 嘉立创 EDA 当前图纸检查

- 实时原理图中，新单位按钮的 1 脚为 A4、2 脚为 GND；原去皮按钮仍为 A5—GND。与新增固件的上拉、低电平有效逻辑一致。
- PCB 上两个按钮、核心板双排插座、HX711 4P/6P 接口、称重梁四线接口、OLED 接口、DS18B20 三线接口和 4.7 kΩ 上拉电阻已放置。原理图中 HX711 数字 4P 口标为 `5V/B13/B12/GND`，与目前选定的 5 V 模块供电方向一致。
- 2026-10-24 在 EDA 中运行 PCB DRC：**8 条连接性错误，均为 GND 网络**。对象为 H2_1、H2_2、g/kg转换按钮_2、去皮按钮_2、H3_2、HX711-4P_4、OLED接插口_1、DS18B20传感器_3。其他信号网络此次未被 DRC 列为未连接；但这不代替对焊盘编号和实物方向的核对。
- 当前 PCB 上可见 GND 飞线，地网尚未完成。应将上述地焊盘通过 GND 铺铜或走线连接，重新填充并跑 PCB DRC，直到连接性错误为零。原理图 DRC 另有约 30 条孤立引脚警告，大多对应核心板未用 GPIO；需逐条确认，并对有意不接的引脚加无连接标识。
- 尚未核验底板四个支撑固定点的最终孔径和位置，也未复核 HX711 模块、核心板插座的最终安装方向。下单前需做 1:1 实物/纸样复核。
- HX711 VCC 计划用 5 V，而 STM32 GPIO 为 3.3 V；需再核实模块 DVDD 电平及 PB12→PD_SCK、DOUT→PB13 的电平兼容性。现有实测曾正常通信，不等于对所有模块或工作条件有规格保证。由于此前模块供电曾混用，装板固定 5 V 后需重新校准。

## 下一步硬件验证

空载上电后下载新固件，确认默认显示 g；短按 PA4，OLED 切换为 kg 且串口出现 `display_unit=kg`；再短按回到 g。按住不放应只切换一次；PA5 去皮仍应独立工作。称重对比可用现有 500 g 砝码，预期同一次称量在两种模式分别约显示 `500.0 g` 和 `0.5000 kg`，实际读数须现场记录，不能把预期值当作测试结果。
