Roxywwww/-/实验数据/阶段记录/2026-10-24_PCB缩板与铺铜调整记录.md

# PCB 缩板与铺铜调整记录（2026-10-24）

## 背景

嘉立创 PCB 免费券在原订单中显示不可用，拟先将控制板外形控制在 100 mm × 100 mm 以内，再重新上传核对优惠券。优惠券是否最终可用，以重新上传后的订单页面为准。

## 修改

- 工具：嘉立创 EDA 专业版，项目中的 `PCB1`。
- 修改前板框：103.505 mm × 57.658 mm。
- 修改后板框：**99.000 mm × 57.658 mm**。板框起点 X 从 −0.127 mm 改为 4.378 mm，右边界位置保持不变；板内元件及走线未移动。
- 顶层 GND 铺铜 `POUR1` 的矩形边界同步改为：起点 (4.678 mm, 0.300 mm)，宽 98.400 mm，高 57.058 mm，即距新板框四边各约 0.3 mm。重新生成铺铜并保存 PCB。

## 检查与后续

- 嘉立创 EDA 保存成功；重新运行 PCB 设计规则检查，界面显示“全部(0)”错误。
- 本次只验证了设计文件尺寸和 DRC，没有验证优惠券审核结果，也没有提交订单。
- 之前打印的 1:1 纸样对应旧板框；若还要核对外壳或支撑位置，应由修改后的 PCB 重新导出并按 100% 比例打印。
- 重新下单时应从已保存的新版 PCB 生成或上传生产文件，核对订单识别尺寸为 99.000 mm × 57.658 mm，再检查免费券状态。
