Roxywwww/-/实验数据/阶段记录/2026-10-25_模块供电电容与载板去耦核对.md

# 模块供电电容与载板去耦核对

日期：2026-10-25。阶段：设计资料审阅，未修改固件、原理图或 PCB，未进行电源纹波或新增电容前后的对比实测。

## 资料中的已有电容

1. STM32 核心板原理图：`C:/baidunetdiskdownload/STM32入门教程资料/模块资料/1-STM32F103C8T6核心板/STM32F103C8T6核心板原理图.pdf`。图中 C3、C4、C10、C11 标注 104，即 100 nF，接在 3.3 V 与地之间；稳压部分 C5 标注 105（1 µF）、C6 标注 106（10 µF）、C8 标注 104（100 nF）。资料所示接口为 Micro-USB，使用者实际核心板为 Type-C，不能据此确认实物的全部型号与电容参数完全一致。
2. HX711 模块资料原理图：`C:/baidunetdiskdownload/A1-3-4C/电子秤HX711AD模块资料包/ADC模块原理图.pdf`。图中 VCC 对地 C6 为 1 µF，AVDD 对地 C7 为 1 µF，VBG 对地 C8 为 1 µF；另有输入通道滤波电容 C4、C5（均标注 0.1 µF）。该图为资料提供的电路，实物版本仍需对应核查。

因此，载板没有额外配置电容，不等于完整系统没有供电电容。模块电容靠近模块内部芯片，有局部去耦作用；载板仍可配置接口附近的电容，减少供电路径阻抗和负载变化带来的影响。

## 后续建议与验证边界

- 后续版 PCB 可在 HX711 插座附近预留 5 V 对 GND 的 100 nF 陶瓷电容与 10 µF 储能电容，并联接入，连接尽量短。这是设计建议，未在本机验证收益，不代表当前载板必须报废重做。
- 电容主要缓冲短时电流变化并降低部分电源噪声，不能修复电源持续压降，也不能代替稳压器或温度补偿。
- 普通万用表的直流读数（例如 4.89 V、3.28 V）不能说明高频纹波是否足够小。目前不能量化未加载板电容对称重波动的贡献。
- 若进行对比，应固定供电、载荷、接线与机械状态，保留前后原始计数及温度；由于重新去皮可能改变偏移，不应仅凭显示归零来判断供电改善。

参考：Analog Devices《MT-101: Decoupling Techniques》，https://www.analog.com/MT-101 。
