Roxywwww/-/实验数据/阶段记录/2026-10-15_核心板供电原理图核对与方案.md

# STM32F103C8T6 核心板供电原理图核对与方案

日期：2026-10-15  
性质：设计依据与待验证接线方案；本日未进行供电实测

## 图纸来源与版本限制

用户提供的 `C:\baidunetdiskdownload\STM32入门教程资料\模块资料\1-STM32F103C8T6核心板\STM32F103C8T6核心板原理图.pdf` 为单页核心板原理图，标题栏标注日期 2014-06-02。图中电源接口为 **USB-micro**，而用户手中的实物照片显示 **Type-C**。因此以下为图纸所示网络关系，不能未经测量就视为实物板完全相同的电路或排针方向。

## 图纸中的电源关系

- USB 接口的 VBUS 直接接到标为 `5V` 的网络；USB GND 接板上 GND。
- `5V` 网络接稳压器 U3 的 VIN 与 EN；U3 的 VOUT 为 `VCC3V3`，供给 STM32 的 VDD/VDDA 等电源脚。图纸没有给出 U3 的明确型号，不能仅据图纸确定最大可带负载电流。
- P4 排针在图纸中标有 `VCC3V3`（第 1 脚）、`GND`（第 2 脚）、`5V`（第 3 脚）；P3 排针还引出 `VCC3V3` 与 GND。物理接线须按实物丝印和万用表确认，不能只凭照片推测排针方向。
- P2 的 SWD 接口包括 `VCC3V3`、SWDIO、SWDCLK、GND。该图不能说明用户所用 ST-Link 的电源脚究竟是供电输出还是目标电压检测输入。

由图纸可知，使用 USB 给该版本核心板供电时，`5V` 排针与 USB VBUS 属于同一网络。因此若改从 `5V` 排针注入外部电源，不能再无隔离地同时接入另一只 USB 5V 电源，以免两个电源相互回灌。

## 现阶段采用的供电方案

计划在最终 PCB 上插装核心板，保持核心板 Type-C 口可从外壳接触。展示时以单一路 5V USB 电源或充电宝接 Type-C：开发板稳压器为 MCU 提供 3.3V；在确认实物 `5V` 排针确与 USB 输入相连、且电源余量足够后，由该 5V 网络给 HX711 模块供电。HX711、STM32 和其他模块共地。ST-Link 仅在烧录/调试时连接所需信号和 GND，是否接其电源/目标电压脚须按该 ST-Link 型号确认；USB 转串口模块也不要再接入一根额外供电线。

传感器电桥由 HX711 模块激励。输入 5V 的变化可能改变 HX711 模块上的实际 E+ 电压，但 HX711 与电桥组成的比例测量链路可能抵消一部分供电变化，不能仅凭原理图定量推断误差。最终应在同一供电方式、固定机械结构下去皮和标定，并用实测检验供电稳定性。更换供电方式后应复测零点和标定点。

## 通电前后的核对项目

1. 拔掉 ST-Link 的供电线和其他电源，仅接 Type-C 5V；确认程序能运行。
2. 用万用表直流电压档，黑表笔接实物 GND，分别测标 `5V` 与 `3V3` 的排针，记录电压和极性。预期分别接近 5V 和 3.3V；实际值以测量为准。
3. 接入 HX711 后再测一次 5V、3.3V、HX711 VCC-GND 和 E+-E-，确认无明显压降，并记录空载 raw 稳定性。
4. 若要改为 PCB 独立 5V 插口，先确认实物排针网络和 USB 口的回灌路径，再决定是否增加电源选择或隔离电路。

本记录是设计核对，不是已经完成的供电实验；上述测量值和最终选择需要后续追加实测结果。
