Roxywwww/-/实验数据/阶段记录/2026-10-16_任务书对照进度与差距.md

# 任务书对照：当前进度与差距

日期：2026-10-16  
依据：用户提供的任务书截图、当前 `hx711test` 工程及 2026-10-13～15 的实验记录。本文是阶段核对，不是指标验收；本次没有修改固件或硬件。

## 任务书中的目标

任务书明确写有：STM32F103 + HX711、**350 g 单点式称重传感器**、DS18B20、SSD1306 OLED；目标工作范围 **0～350 g**、显示分辨率 **0.1 g**、非线性 ≤±0.5%；去皮、滤波、温度补偿；在 10/20/30/40 °C 和多载荷下比较补偿前后误差，给出补偿系数、温漂曲线、误差分布图。正文一处称 HX711 增益“128/64”，另一处明确写“A 通道增益 128，B 通道固定 32”。

## 已完成并有证据的部分

| 项目 | 当前状态与证据 |
|---|---|
| STM32 与 HX711 通信 | STM32F103C8T6、PB12=SCK、PB13=DOUT；独立驱动读取 24 位有符号原始值，25 个时钟保持下一次 A 通道 128 倍增益，DOUT 等待设超时。接线错误曾出现 `-8388608`，修正后空载约 3.3 万计数且加载变化明显。见[接线排查记录](2026-10-13_20kg传感器与HX711接线排查记录.md)。 |
| 串口、去皮、换算 | USART1 115200；开机 16 次采样取零点、PA5 按键去皮；初步比例系数 177.6184 计数/g，输出 `raw/net/g`。500 g 标称砝码参与了系数求取，故其读数不能作为独立精度验证。见[标定记录](2026-10-15_100至800g砝码标定与零点复测记录.md)和[克数固件记录](2026-10-15_串口克数输出开发与砝码复测记录.md)。 |
| 基础滤波 | 5 点滑动平均，输出 `g_avg`；稳定状态下短时样本标准差由约 0.15 g 降到约 0.087 g，同时卸载响应变慢。见[滤波实测](2026-10-15_5点滑动平均滤波开发与实测记录.md)。 |
| OLED | PB8/PB9 软件 I²C，OLED 已显示 `g_avg`；用户目视确认 500 g 时约 500.5 g，按键去皮后回到零附近；Keil 编译 0 错误、0 警告并下载成功。见[OLED 实测](2026-10-15_OLED软件I2C移植与称重显示实测记录.md)。 |
| 初步多点数据 | 标称 100、200、300、500、700、800 g 及空载已有原始串口记录。100/200/300 g 与任务书范围相关，但这批数据来自临时结构、20 kg 称重梁、500 g 标定，不能当作最终 0～350 g 指标验收。 |

## 关键差距与风险

1. **硬件与任务书不一致，优先级最高。** 任务书指定 350 g 单点传感器和 0～350 g 系统，现阶段使用 20 kg 称重梁。0～350 g 只占其额定载荷的 1.75%。软件限制显示上限并不能把它变成 350 g 传感器。应与导师确认：改用适配 350 g 工作范围的传感器，或正式修改任务书的传感器和量程指标；不能在论文中把现用 20 kg 传感器写成 350 g。
2. **单一增益目前不是最主要缺口。** 当前驱动固定 A 通道 128 倍增益；这与任务书“称重原理”段的“A 通道增益 128”一致。HX711 的其他增益/通道是芯片能力，不等于此秤必须实时切换。但任务书前文另写“增益 128/64”，两段表述需要导师明确：是只要求介绍芯片可选增益，还是要求实测 A64 与 A128。若要求对比，届时再扩展驱动并分别标定；不应为凑功能在测量过程中随意切换。
3. **0.1 g 显示步进尚未证明 0.1 g 测量能力。** 当前程序把结果四舍五入显示到 0.1 g，但 5 点平均后的短时标准差约 0.087 g；500 g 卸载后的空载平均曾约 +0.5 g，另一次观测由 +0.28 g 上移到 +0.56 g。需要在最终结构下测试稳定性、重复性、回零和最小可辨变化，不能把显示小数位写成准确度或分辨能力已达标。
4. **量程和非线性尚未验收。** 尚无最终结构下 0～350 g 的多点、双向、多轮实验，且参考砝码实际质量未独立核验。任务书“非线性 ≤±0.5%”未注明相对于满量程还是读数，也未说明拟合方法，建议先向导师确认再设计判据。
5. **温度主线基本未开始。** 尚无 DS18B20 采温程序、温度与称重数据的同步记录、10/20/30/40 °C 四温点、多载荷温漂试验、零点与灵敏度系数拟合、补偿前后对比及图表。现有回零偏差不能直接归因于温度。任务书写的温漂单位“°C/°C”不对应重量变化，需确认究竟要求 g/°C、计数/°C 或其他指标；温漂公式的变量与系数定义也宜在开题前写清。
6. **信号调理、滤波和显示仍有未完成项。** 目前使用现成 HX711 小板，尚未以最终电路/PCB 验证任务书所称的差分放大、基准与滤波电路。软件只实现 5 点滑动平均，未实现或验证所写的 IIR/50/60 Hz 方案；OLED 只显示 g，未做 g/kg 切换。不能把 HX711 的内部功能、软件处理和自行设计的模拟电路混称为同一成果。
7. **机械与供电未定型。** 当前数据来自临时秤盘、面包板/杜邦线阶段；正式底座、PCB 和供电方式定型后，零点、比例系数、噪声和温漂数据都应重新测量，不可直接沿用临时系数作为最终性能证明。

## 建议的工作顺序

1. **先与导师锁定项目口径**：350 g 传感器/0～350 g 指标是否必须严格按任务书执行；增益 128/64 是否需要实验；“非线性 ≤±0.5%”和温漂指标的分母/单位是什么。若保留 20 kg 方案，应走任务书正式变更，重新评估 0.1 g 指标和参考载荷。
2. 传感器、秤盘与底座定型，检查加载路径和是否蹭底；设计/制作最终接口 PCB 与稳定供电。固件保留原始 `raw` 输出，便于对照。
3. 用目标范围内可信参考质量做多点重复加载、卸载、不同摆放位置试验；重新去皮和标定，单独评估显示波动、回零、重复性、非线性。标定用点和独立验证用点应分开。
4. 完成 DS18B20 读取并与每组重量数据同记时间和温度，再设计四温点零点/灵敏度实验。以统一机械和供电条件采集补偿前数据，然后拟合补偿系数并用独立数据验证效果。
5. 最后补 IIR 或所需抗干扰方案、g/kg 切换、对比图表和论文论证。若任务书继续要求“50/60 Hz IIR”，应先明确 HX711 输出采样率与该表述的实际含义，再选可验证的方法。

## 当前结论

现阶段可称为**称重功能原型已跑通**：采集、去皮、初步标定、移动平均和 OLED 显示都有实测证据。尚不能称为已达到任务书规定的 0～350 g、0.1 g 分辨能力、≤±0.5% 非线性或温度补偿指标。下一次实质性决策是先统一传感器与量程目标，而不是先增加增益切换代码。
