Roxywwww/-/实验数据/阶段记录/2026-10-22_PCB板框与STM32插座定位记录.md

# PCB 板框与 STM32 插座定位记录（2026-10-22）

## 目的与依据

在现有嘉立创 EDA 专业版工程 `电子秤毕业设计` 的 PCB1 上，先确定接口底板外形和 STM32F103C8T6 核心板的两排插座位置，后续由本人完成走线。参考资料为 `C:\baidunetdiskdownload\STM32入门教程资料\模块资料\1-STM32F103C8T6核心板\STM32F103C8T6核心板尺寸.pdf`。该资料给出的旧版核心板外形为 2100 × 900 mil（53.34 × 22.86 mm），两排针中心距为 600 mil（15.24 mm），同排针距为 100 mil（2.54 mm），每排 20 针。此前规划记录误写成 800 mil（20.32 mm），本次已核对并纠正。

## 本次实际操作

| 对象 | 当前 PCB 参数 |
| --- | --- |
| 矩形板框 | 110.000 × 70.000 mm；左上起点 X=24.384 mm、Y=0 mm；未倒圆角 |
| H3，STM32 左排 1×20 插座 | 中心 X=99.568 mm、Y=−35.179 mm；旋转 90° |
| H2，STM32 右排 1×20 插座 | 中心 X=114.808 mm、Y=−35.179 mm；旋转 270° |
| 两排中心距 | 114.808 − 99.568 = **15.240 mm**；两排 Y 坐标相同 |

已在 EDA 中保存，界面显示“保存成功”。PCB 上原有的称重梁、HX711、OLED、温度探头和按键接口保持原位，尚未布线或铺铜。本次只是机械初排，110 × 70 mm 是为了容纳当前器件的暂定底板尺寸，不是已完成的结构校验值。

## 制板前核对项

1. 参考 PDF 是旧版核心板；实际为 Type-C 版本。按 1:1 比例打印两排孔位，拿已焊公针的实物试插，同时核对 1 脚方向、板长、板宽和 Type-C 插头的插拔空间。尤其要确认用户手中这块实物的排距确为 15.24 mm。
2. 选定四角支撑柱的实际规格与螺丝尺寸后，再放相应的机械安装孔，并检查孔到板边、其他元件及螺丝头的间隙。本次未放安装孔；不能用普通电气过孔代替。
3. HX711 的 6P+4P 两个插座同样需 1:1 实物试插；其相对孔位目前没有尺寸资料证明正确。
4. 走线前检查所有插座焊盘编号与原理图的网络对应关系，尤其是 H2/H3 的首尾方向；再做 ERC/DRC。当前的飞线只是待连接网络，不表示已连通。

这份记录描述设计与软件操作结果，没有宣称已经打板、完成电气检查或验证称重精度。
