Roxywwww/-/实验数据/阶段记录/2026-10-22_原理图第二轮核对.md

# 2026-10-22 原理图第二轮核对

本条根据用户当天提供的嘉立创 EDA 原理图截图记录设计进度，不是硬件性能实验数据。截图显示 DS18B20 三线接口、R1 4.7 kΩ 上拉、PA5 去皮按键和 OLED 四线接口已画出；仅凭截图不能证明封装关联、网表连通或 ERC 已通过。

## 已核对的固件引脚

- `PB12`：HX711 SCK；`PB13`：HX711 DOUT。
- `PA12`：DS18B20 DQ；`PA5`：去皮按键，固件按上拉输入、按下为低电平处理。
- OLED：`PB8` SCL、`PB9` SDA，模块使用 3.3 V 供电。

以上引脚来自当前 `hx711test/Core/Inc/main.h` 与 `.ioc`，与截图中的 MCU 侧标注基本一致。

## 转 PCB 前必须处理

1. 左上“体重秤信号接口”四针目前标注 `3.3V/B13/B12/GND`，与旁边 HX711 数字四针接口相同。如果该口是称重梁四芯入口，应改成 `E+/E-/A-/A+` 并连接 HX711 六针侧。已排查过的实物线色是白=E+、黑=E-、红=A-、绿=A+；焊接时还要按实物连接器正反面复核孔号。
2. 图上既有 `3.3` 也有 `3.3V`。如果在 EDA 里它们是不同网络名，供电会断开；应统一电源网络名称并查看网表。HX711 四针口当前标 3.3V，与此前 5V 测试接法不一致，需按最终实测供电方案定稿并核对 MCU 输入电平。
3. 新截图的温度三针看起来是 `1=3.3V、2=DQ/PA12、3=GND`，而上一版规划记录约定 `1=GND、2=DQ、3=3V3`。两种顺序都能设计，必须统一原理图脚号、PCB 焊盘号、丝印和三芯线实物线序。当前视为待核实，不能按旧记录直接焊线。R1 应确实跨接 DQ 与 3.3V。
4. 去皮键 PA5 接 GND 与固件逻辑一致。OLED 图上 1=GND、2=3.3V、3=PB8、4=PB9，与已验证接法一致；仍需核对模块实物丝印和封装脚号。

下一步是逐针核对接口、确认三针焊线口的封装与焊盘编号、运行 ERC、检查转板网表，再做 1:1 纸样试插。当前截图还不足以判定 PCB 可下单。

## 同日后续截图：称重梁接口和 HX711 供电已修正

用户后续截图中，左上称重梁四芯口已改为 `1=E+、2=E-、3=A-、4=A+`，并与 HX711 六针侧的同名网络对应；HX711 数字四针口已改为 `1=5V、2=B13、3=B12、4=GND`。这是本轮图纸修正，尚无新硬件实测数据。HX711 六针侧的 B-、B+ 保持未用，符合当前只用 A 通道的方案。

仍须核查：温度上拉电源标成 `3.3`，而 STM32 H3 与 OLED 处标成 `3.3V`；两者若为不同网络名则不连通。温度三针当前从上至下为 `1=3.3、2=A12/DQ、3=GND`，需要按这个最终顺序统一 PCB 焊盘和丝印，不能沿用上一版的反向编号。HX711 模块实物四针的 VCC/DT/SCK/GND 排列及电平仍要逐针核实；当前 5V 供电与 STM32 3.3V GPIO 相接，不能只凭网名判断数字电平兼容性。按键与 OLED 网络未见变化。

## 用户对两个 3.3 V 引脚的说明

用户说明核心板两侧各有一个 3.3 V 引脚，原理图故意分别命名 `3.3` 与 `3.3V`，以便辨认使用的是哪一侧。前述“不同网名可能导致温度接口不通电”只适用于把核心板当作没有内部连接的原理图器件来分析；实物核心板插装后，若两引脚确属同一稳压器输出，它们会在核心板内部相连，不能据此判定实际断电。仍建议将电源**网络名**统一为 `3V3`，用 `H2-3V3`、`H3-3V3` 等注释或引脚标注区分物理位置，便于 ERC、网表和 PCB 检查。最终以核心板资料或断电通断测量确认两脚确为同一电源节点。本段为图纸解释修正，不是新增实测结果。
