Roxywwww/-/文档/开题报告/历史版本/2026-10-18/基于STM32的电子秤设计与温度补偿研究_开题报告初稿_2026-10-18.md

# 基于STM32的电子秤设计与温度补偿研究 开题报告初稿

> 按学校系统的五个栏目编排，正文为开题阶段的研究计划。当前实测只用于说明可行性，后续性能指标以最终装配和独立实验结果为准。

## 一、选题的背景与意义

电子秤广泛用于物品计量、分装和实验室辅助测量。应变式称重传感器将载荷引起的金属梁形变转换为电桥差分电压，输出信号较弱，需要放大和高分辨率模数转换后才能由单片机处理。STM32F103具有通用输入输出、定时与串口等资源，适合完成传感器采集、按键操作和显示控制；HX711集成差分输入、可编程增益放大和24位模数转换，可承担称重信号的采集任务[1-2]。采用这些器件制作电子秤，既能完成一套可运行的嵌入式系统，也便于对采样、标定与误差处理过程进行定量研究。

称重结果并非只受模数转换器位数决定。传感器弹性体、电桥、供电、安装受力、加载历史与环境温度都可能改变零点或灵敏度。有关称重传感器的研究指出，加载后的回零误差与机械迟滞有关，传感器内部温度场也会影响温度补偿效果[5-6]。因此，看到空载读数变化时，不能立即将其全部归因于温度，更不能只通过显示置零掩盖误差。需要保持机械与供电条件一致，记录温度和原始读数，分别分析短时噪声、卸载回零与温度相关漂移。

本课题以现有STM32F103C8T6、HX711和额定20 kg应变式称重传感器为基础，研究电子秤的硬件连接、质量换算、数字滤波及温度补偿。原任务书中的350 g传感器和0～350 g范围是选型参考，指导教师已允许根据实际器件调整。现阶段已有100～800 g标称砝码的功能验证数据；后续将在机械结构定型后，按可获得的可信参考载荷明确实际验证范围。0.1 g可作为显示步进进行设计，但是否具备相应的测量分辨能力和准确度，必须由重复性、回零和误差实验判断。课题的意义在于建立一条从电桥信号到可解释称重结果的完整链路，并用实验检验补偿方法在实际样机上的作用。

选择20 kg传感器也带来研究边界：小质量仅使用额定载荷中的一小部分，输出变化与噪声、安装应力之间的比例可能不利于细分辨率。因此报告将把“屏幕能显示多少位”和“在指定质量范围内能稳定区分多少质量”分开表述；最终结论只覆盖实际测过的载荷和温度。这样的界定比直接沿用任务书中的数字更符合现有硬件，也便于答辩时用原始记录说明每一项判断。

## 二、研究的基本内容与拟解决的主要问题

系统由称重梁、HX711采集模块、STM32控制板、DS18B20温度传感器、OLED、去皮按键及供电接口构成。称重梁电桥连接HX711的A通道；STM32通过DOUT与SCK读取24位有符号数据，使用第25个时钟选择下一次A通道128倍增益。DS18B20经1-Wire接口采集称重梁附近温度[3]；OLED显示质量和运行状态[4]，USART1保留原始数据与调试信息。电路与PCB设计将重点核查电源、共地、模拟输入走线和传感器接口，避免将现成HX711模块的内部放大器误写为自行设计的模拟电路。

软件首先建立可追溯的基准测量：开机或按键取得空载零点，已知质量求得计数与克之间的比例，再输出瞬时质量和滤波后质量。已有原型实现了HX711读取超时、符号扩展、开机及按键去皮、初步标定、五点滑动平均和OLED显示。临时装配下求得的比例系数约为177.6184计数/g；五点平均使一次稳定测试中的短时标准差由约0.15 g降至约0.087 g，但卸载后曾观察到约0.5 g回零偏差。这些结果只证明功能链路已跑通，也提示机械状态与零点需要进一步控制；标称500 g曾用于求取比例系数，不能再把其接近500 g的显示值作为独立准确度证据。

研究需要解决三个主要问题。第一，20 kg额定传感器在较小载荷段输出变化相对有限，显示0.1 g与实际可分辨质量不能混同。须在最终底座和秤盘固定后评估噪声、重复性、偏载、迟滞及回零，并确定有证据支持的工作范围。第二，滤波降低读数抖动时也会增加响应时间，需在相同数据条件下比较原始输出和滤波输出，不把短时标准差的下降写成系统准确度提升。第三，温度变化可能同时改变空载零点和载荷对应的比例系数；只在开机时去皮不能保证升温或降温后仍为零。拟把原始计数表示为R(T,m)=b(T)+k(T)m+ε，其中b(T)为空载零点，k(T)为计数/克灵敏度，ε为尚未解释的噪声及其他误差。通过不同温度下的空载和已知载荷数据分别估计b与k，再比较补偿前后的质量误差。温度之外的机械回弹和供电波动应单独记录，防止模型把偶发因素误学成温漂。

预计形成的成果包括：可复现的原理图与程序、关键接线及标定说明、按温度和载荷组织的原始数据、补偿系数与计算过程、补偿前后对比图，以及对未达预期指标原因的分析。实验数据按日期和状态保存，异常读数不直接删除；若需剔除，须写出事先定义的判据及其对结论的影响。

## 三、研究的方法与技术路线

首先阅读STM32F103、HX711、DS18B20和OLED的原始技术资料，确定供电、电平、采样时序和通信方式[1-4]。沿用STM32CubeMX与HAL工程，保持称重ADC由HX711完成；驱动按模块编写，先验证单元读数，再逐步接入温度。当前HX711固定使用A通道128倍增益；若后续实验发现信号饱和，才评估切换A通道64倍增益，并对不同增益分别标定，不在正常称重中任意切换。使用串口保存带时间标记的`raw`、去皮后计数、瞬时克数、滤波克数和温度，使OLED读数能追溯到原始记录。

其次完成机械与电路样机。秤盘应只通过预定受力路径加载称重梁，检查螺钉、底座、导线是否碰触活动部位，固定DS18B20的测温位置并避免其施加额外机械力。供电、HX711模拟端和STM32数字端分别核查电压与共地关系；PCB完成后重新做空载去皮和比例标定，不能沿用面包板阶段的系数。温度传感器先独立验证1-Wire时序、读数有效性和异常处理，再将温度读数与同一时段的称重记录关联。为避免DS18B20转换等待妨碍HX711采集，主循环将安排温度转换启动与稍后读取，分别检查通信超时和数据完整性。

标定实验在结构固定、预热和供电条件一致时进行。记录空载及多个已知质量点，采用加载、卸载和重复加载顺序；每个稳定状态保存一组连续原始样本。以部分质量点求取零点和灵敏度，另留至少一个未参与拟合的质量点检验误差，并记录放置位置与稳定等待时间。对同一载荷计算平均值、标准差、最大偏差和卸载回零差，绘制载荷—输出关系；若参考载荷覆盖不足，则只报告已测区间，不推断20 kg全量程性能。数字滤波以当前五点滑动平均为基线，比较滤波前后稳态波动和加载响应；任务书提及的IIR与50/60 Hz处理，应先结合HX711实际输出速率和干扰来源确定可实现的方案，再做同条件对比。

温度实验拟选择四个可稳定维持并能安全测量的温度点，以任务书建议的10、20、30、40 ℃为目标；若设备条件无法达到，则如实记录实际温度范围，不虚构温点。每个温点等待称重梁与DS18B20读数接近稳定，分别测空载和至少两个参考质量，固定传感器位置、供电、秤盘与采样时长，同时记录升温或降温方向。以参考温度T₀的零点b₀和灵敏度k₀为基准，先检验线性模型b(T)=b₀+α(T−T₀)、k(T)=k₀[1+β(T−T₀)]是否足够描述数据；若残差呈系统性变化，再考虑分段插值，但避免在样本量不足时使用复杂模型。补偿质量按m̂=[R−b(T)]/k(T)计算。此处“去皮后的温漂”定义为在T₀去皮后、不再次手动去皮时，空载显示质量随温度变化的斜率，单位为g/℃；另对带载误差与灵敏度变化单独报告，避免混用指标。

最后将不同日期或不同升降温轮次的数据分为建模组和独立验证组，不用同一批数据既拟合又宣称验证成功。对比补偿前后的空载漂移斜率、各质量点平均绝对误差、最大绝对误差及误差随温度的变化，并给出拟合曲线与残差图；R²只用于说明模型对建模数据的拟合程度，不替代独立验证误差。若机械迟滞、供电变化或温度滞后使补偿无明显改善，也应保留原始数据，分析原因并说明模型适用范围。这样形成“硬件定型—基准标定—同步测温—建模—独立检验”的技术路线。

数据分析时将区分三类量：ADC原始计数、扣除零点后的净计数和换算后的克数。每张图标明单位、样本数与温度稳定条件；补偿前后采用相同的测试样本，避免由于重新去皮、调整摆放或筛选数据而造成表面上的误差下降。若只获得少量温点，则优先采用参数少且可解释的线性模型，并在论文中明确外推到未测温度没有实验依据。

## 四、研究的总体安排与进度

2026年10月：查阅器件资料和相关研究，明确以现有20 kg传感器为对象的实验边界，完成任务书与开题报告；整理已取得的接线排查、串口标定、滤波和OLED记录。2026年11月：完成文献综述与系统方案，确定机械安装、供电和PCB接口，列出实验所需参考质量与温度条件。2026年12月至2027年1月：完成样机结构与PCB制作，完善DS18B20采温、异常处理和串口数据记录，重新标定固定后的称重系统。2027年2月至3月：开展多点加载、卸载、重复性及温度实验，拟合零点与灵敏度温漂模型，使用独立数据比较补偿前后误差，形成论文初稿。2027年4月：补充必要复测，检查图表、单位与结论一致性，修改论文并准备中期或预答辩材料。2027年5月：完成论文定稿、答辩和数据归档。若温控或参考质量条件受限，及时缩小并明确可验证范围，不以未测范围代替实测结论。

每一阶段以可检查的产出作为完成条件：硬件阶段保留供电和引脚核对记录，软件阶段保留编译日志及串口原文，实验阶段保留砝码组合、温度、时间和加载顺序，论文阶段使图表能够追溯到对应的原始文件。温度补偿程序只有在独立验证组中表现出稳定改善后，才作为最终测量结果的一部分。

## 五、主要参考文献

[1] STMicroelectronics. STM32F103x8 STM32F103xB datasheet, DS5319 Rev 20, 2025. https://www.st.com/resource/en/datasheet/stm32f103c8.pdf

[2] Avia Semiconductor. HX711 24-Bit Analog-to-Digital Converter (ADC) for Weigh Scales, Version 2.0. https://e2e.ti.com/cfs-file/__key/communityserver-discussions-components-files/73/HX711.pdf

[3] Analog Devices. DS18B20 Programmable Resolution 1-Wire Digital Thermometer, Rev. 6, 2019. https://www.analog.com/media/en/technical-documentation/data-sheets/ds18b20.pdf

[4] Solomon Systech. SSD1306 128×64 Mono OLED Driver with Charge Pump, product information. https://www.solomon-systech.com/product-category/oled-display

[5] Zhuang S, Yang W, Cheng X, et al. Analysis of Return-to-Zero Error after the First Load of Load Cell. Sensors, 2023, 23(21): 8712. https://doi.org/10.3390/s23218712

[6] Zhuang S, Yang W, Zhou Y, et al. Temperature Field Analysis and Compensation Improvement of Load Cell. Scientific Reports, 2024, 14: 26213. https://doi.org/10.1038/s41598-024-76688-0
