Roxywwww/-/实验数据/README.md

# 实验数据索引

本目录保留实际采集数据与阶段记录。开题报告采用研究计划写法，已经开展的开发过程和实测结果在这里查阅。

| 目录 | 内容 |
| --- | --- |
| [阶段记录](阶段记录/) | 操作过程、实现状态、分析结论和验证边界 |
| [原始数据](原始数据/) | 串口CSV及原始文本 |
| [图片](图片/) | 接线、孔距核对与纸样试插图片 |
| [构建日志](构建日志/) | 阶段记录引用的历史编译/下载日志，以及本次整理后的编译结果 |

## 阶段记录

- [2026-10-27_知网参考文献格式核对与排版调整](阶段记录/2026-10-27_知网参考文献格式核对与排版调整.md)
- [2026-10-27_开题报告语言修订与引用核查记录](阶段记录/2026-10-27_开题报告语言修订与引用核查记录.md)
- [2026-10-27_开题报告计划写法与目录整理记录](阶段记录/2026-10-27_开题报告计划写法与目录整理记录.md)
- [2026-10-25_模块供电电容与载板去耦核对](阶段记录/2026-10-25_模块供电电容与载板去耦核对.md)
- [2026-10-24_PCB缩板与铺铜调整记录](阶段记录/2026-10-24_PCB缩板与铺铜调整记录.md)
- [2026-10-24_PA4单位切换与PCB接线核对](阶段记录/2026-10-24_PA4单位切换与PCB接线核对.md)
- [2026-10-24_PA3单位切换与PCB同步记录](阶段记录/2026-10-24_PA3单位切换与PCB同步记录.md)
- [2026-10-23_HX711供电条件更正与第二按键方案](阶段记录/2026-10-23_HX711供电条件更正与第二按键方案.md)
- [2026-10-22_原理图第二轮核对](阶段记录/2026-10-22_原理图第二轮核对.md)
- [2026-10-22_PCB板框与STM32插座定位记录](阶段记录/2026-10-22_PCB板框与STM32插座定位记录.md)
- [2026-10-22_HX711模块6P4P插座定位记录](阶段记录/2026-10-22_HX711模块6P4P插座定位记录.md)
- [2026-10-20_接口底板原理图与PCB规划](阶段记录/2026-10-20_接口底板原理图与PCB规划.md)
- [2026-10-18_DS18B20单总线温度读取开发与验证记录](阶段记录/2026-10-18_DS18B20单总线温度读取开发与验证记录.md)
- [2026-10-16_任务书对照进度与差距](阶段记录/2026-10-16_任务书对照进度与差距.md)
- [2026-10-15_核心板供电原理图核对与方案](阶段记录/2026-10-15_核心板供电原理图核对与方案.md)
- [2026-10-15_串口克数输出开发与砝码复测记录](阶段记录/2026-10-15_串口克数输出开发与砝码复测记录.md)
- [2026-10-15_PA5按键去皮开发记录](阶段记录/2026-10-15_PA5按键去皮开发记录.md)
- [2026-10-15_OLED软件I2C移植与称重显示实测记录](阶段记录/2026-10-15_OLED软件I2C移植与称重显示实测记录.md)
- [2026-10-15_5点滑动平均滤波开发与实测记录](阶段记录/2026-10-15_5点滑动平均滤波开发与实测记录.md)
- [2026-10-15_100至800g砝码标定与零点复测记录](阶段记录/2026-10-15_100至800g砝码标定与零点复测记录.md)
- [2026-10-13_20kg传感器空载去皮与串口验证记录](阶段记录/2026-10-13_20kg传感器空载去皮与串口验证记录.md)
- [2026-10-13_20kg传感器与HX711接线排查记录](阶段记录/2026-10-13_20kg传感器与HX711接线排查记录.md)

## 原始数据

各组采集条件、砝码组合与异常处理见对应阶段记录。文件名中的日期和标称质量不是重新检定结果。

- [10.1 hx711实验.txt](<原始数据/10.1 hx711实验.txt>)
- [10.1 hx711手机放置检测实验.txt](<原始数据/10.1 hx711手机放置检测实验.txt>)
- [10.1 手机放置数据异常.txt](<原始数据/10.1 手机放置数据异常.txt>)
- [2026-10-13_20kg传感器接线修正后raw记录.txt](<原始数据/2026-10-13_20kg传感器接线修正后raw记录.txt>)
- [2026-10-13_开机去皮后串口实测.txt](<原始数据/2026-10-13_开机去皮后串口实测.txt>)
- [2026-10-13_空载raw现场采集.txt](<原始数据/2026-10-13_空载raw现场采集.txt>)
- [2026-10-15_5点滑动平均_500g卸载动态实测.csv](<原始数据/2026-10-15_5点滑动平均_500g卸载动态实测.csv>)
- [2026-10-15_5点滑动平均_500g稳定实测.csv](<原始数据/2026-10-15_5点滑动平均_500g稳定实测.csv>)
- [2026-10-15_5点滑动平均_按键去皮动态串口原文.txt](<原始数据/2026-10-15_5点滑动平均_按键去皮动态串口原文.txt>)
- [2026-10-15_5点滑动平均_空载实测.csv](<原始数据/2026-10-15_5点滑动平均_空载实测.csv>)
- [2026-10-15_OLED阶段_500g串口实测原文.txt](<原始数据/2026-10-15_OLED阶段_500g串口实测原文.txt>)
- [2026-10-15_OLED阶段_卸载后延时空载串口实测原文.txt](<原始数据/2026-10-15_OLED阶段_卸载后延时空载串口实测原文.txt>)
- [2026-10-15_OLED阶段_卸载空载串口实测原文.txt](<原始数据/2026-10-15_OLED阶段_卸载空载串口实测原文.txt>)
- [2026-10-15_OLED阶段_按键去皮后空载串口实测原文.txt](<原始数据/2026-10-15_OLED阶段_按键去皮后空载串口实测原文.txt>)
- [2026-10-15_PA5按键去皮串口实测原文.txt](<原始数据/2026-10-15_PA5按键去皮串口实测原文.txt>)
- [2026-10-15_克数固件_100g实测.csv](<原始数据/2026-10-15_克数固件_100g实测.csv>)
- [2026-10-15_克数固件_500g实测.csv](<原始数据/2026-10-15_克数固件_500g实测.csv>)
- [2026-10-15_克数固件_800g实测.csv](<原始数据/2026-10-15_克数固件_800g实测.csv>)
- [2026-10-15_克数固件_按键去皮后空载实测.csv](<原始数据/2026-10-15_克数固件_按键去皮后空载实测.csv>)
- [2026-10-15_克数固件_空载实测.csv](<原始数据/2026-10-15_克数固件_空载实测.csv>)
- [2026-10-15_克数固件_终点空载实测.csv](<原始数据/2026-10-15_克数固件_终点空载实测.csv>)
- [2026-10-15_多点试验_终点空载实测.csv](<原始数据/2026-10-15_多点试验_终点空载实测.csv>)
- [2026-10-15_标称100g砝码_加载实测.csv](<原始数据/2026-10-15_标称100g砝码_加载实测.csv>)
- [2026-10-15_标称200g砝码_卸载实测.csv](<原始数据/2026-10-15_标称200g砝码_卸载实测.csv>)
- [2026-10-15_标称300g砝码_卸载实测.csv](<原始数据/2026-10-15_标称300g砝码_卸载实测.csv>)
- [2026-10-15_标称500g砝码_加载实测.csv](<原始数据/2026-10-15_标称500g砝码_加载实测.csv>)
- [2026-10-15_标称500g砝码_卸载空载实测.csv](<原始数据/2026-10-15_标称500g砝码_卸载空载实测.csv>)
- [2026-10-15_标称500g砝码_重复加载实测.csv](<原始数据/2026-10-15_标称500g砝码_重复加载实测.csv>)
- [2026-10-15_标称700g砝码_加载实测.csv](<原始数据/2026-10-15_标称700g砝码_加载实测.csv>)
- [2026-10-15_标称800g砝码_加载实测.csv](<原始数据/2026-10-15_标称800g砝码_加载实测.csv>)
- [2026-10-18_DS18B20_串口原始数据.csv](<原始数据/2026-10-18_DS18B20_串口原始数据.csv>)

阶段记录引用的历史Keil日志已另存到`构建日志`并更新链接，便于在其他电脑上查阅。这些日志不等同于串口原始数据或精度检定结论。
