Roxywwww/-/硬件资料/README.md

# 硬件资料说明

| 目录 | 用途与状态 |
| --- | --- |
| 早期封装参考 | HX711的KiCad封装和符号参考，属于早期方案；排距曾按照片估算，不作为当前已验证的生产封装 |
| 参考图 | HX711参考电路图 |
| 工程备份 | 嘉立创EDA修改前的历史工程备份，保留原文件名和内容 |

开发板插座定位、HX711 6P/4P定位、纸样试插及PCB修改依据，见[实验记录索引](../实验数据/README.md)。

本目录尚未收入最新PCB的完整工程与Gerber生产包。打板或复用设计前，应从实际嘉立创EDA工程确认版本、尺寸、插座方向和DRC结果，不能把早期参考或历史备份当作当前生产文件。
