Roxywwww/-/实验数据/阶段记录/2026-10-27_知网参考文献格式核对与排版调整.md

# 知网参考文献格式核对与排版调整

日期：2026-10-27。按使用者反馈，检查开题报告参考文献的著录方式与版面。正文研究计划、公式及原有六项参考来源保持对应关系，本阶段没有新增实验。

## 知网期刊平台核对

查阅以下三篇文章在知网期刊平台公开提供的题录、摘要、参考文献列表及引用导出信息，用于比较参考文献写法。页面未直接提供可阅读的论文全文，故不将本次查阅描述为全文精读。

1. 王小娟. 基于HX711数显称重仪的设计[J]. 武汉船舶职业技术学院学报, 2015, 14(1): 36-38.
   https://whcb.cbpt.cnki.net/portal/journal/portal/client/paper/8fbbecf3a014f38eec112aba718da9b1
2. 杨杰, 余红英, 刘辉. 基于STM32的智能称重系统优化设计[J]. 曲阜师范大学学报(自然科学版), 2020, 46(1): 71-76.
   https://qfsf.cbpt.cnki.net/portal/journal/portal/client/paper/490bfc48ee84471fe34df9a6a3caa06d
3. 吴莹妃. 基于单片机与蓝牙传输的电子秤设计[J]. 现代信息科技, 2022, 6(12): 181-185. DOI: 10.19850/j.cnki.2096-4706.2022.012.047.
   https://xdxk.cbpt.cnki.net/portal/journal/portal/client/paper/84cf0864ccf6d69e5bcb443bbeca9291

上述页面可见顺序编码式引用，期刊条目通常按“作者. 题名[J]. 刊名, 年, 卷(期): 页码”组织，学位论文、图书和在线资料则使用各自文献类型的著录项。三篇仅作为本次写法对照，未直接新增到报告参考文献，以保持现有正文引用的含义与序号。

同时核对国家标准信息公共服务平台：GB/T 7714—2025于2026-07-01实施，代替2015版；本次访问的知网期刊页面仍显示GB/T 7714-2015导出选项。最终提交按学校指定模板执行。本次属于版式整理，不据此宣称已逐条核查2025版全文。

官方标准信息： https://std.samr.gov.cn/gb/search/gbDetailedCNF?id=4507EFE13D37CB6AE06397BE0A0A601F 。

## 原版显得拥挤的原因

- 六项来源中，多项是在线数据手册或标准，长题名、版本、访问日期和网址混排，导致频繁折行。
- 机构作者全大写占据较强视觉比重，换行后的文字起点与编号不够整齐。
- 英文题名和网址可能被WPS标记为拼写错误，产生大量红色波浪线；这与文献真实性无关。

## 本次调整

- 保留原有六项来源、序号、版本、日期、完整网址及DOI，未将手册改称期刊论文。
- 统一参考文献正文为宋体/Times New Roman、10.5磅、16磅固定行距、段后4磅；编号单列，使用21磅悬挂缩进和制表位对齐续行。
- 机构名称采用常用大小写形式，个人作者名及期刊信息保持原有写法。
- 在线资料的网址单独换行、用9磅黑色文字，仍保留在对应的同一参考文献条目内。
- 在参考文献文字中加入不检查拼写标记，减少英文名称和网址的红色波浪线。
- 调整前Word和Markdown保存在`文档/开题报告/历史版本/2026-10-27_参考文献排版前`。

## 验证

通过结构对照确认参考文献标题之前的各段文字未变化，五个可编辑数学对象保留，参考文献仍为六条。通过WPS只读导出PDF、Poppler转PNG并逐页查看，文档为4页；检查未见文字遮挡、越界或网址截断。预览仅用于排版验证，交付仍为Word。
