Roxywwww/-/实验数据/阶段记录/2026-10-15_100至800g砝码标定与零点复测记录.md

# 100～800 g 砝码标定与零点复测记录

日期：2026-10-15（北京时间）  
工程：`hx711test`，STM32F103C8T6 + HX711，串口 COM4、115200、8N1  
阶段：已实现 HX711 原始值读取、开机去皮与 PA5 按键去皮；本次仅采集和分析数据，**没有修改固件**

## 目的、操作与数据来源

在用户报告秤盘上放有一枚标称 500 g 砝码后，直接从 COM4 采集 `raw=... net=...`。每组采集时临时关闭串口助手的串口连接，采完立即重新打开；保存的是实际串口行和电脑接收时生成的本地时间戳。电脑时间戳不是 HX711 转换完成时刻。未按去皮键，也未要求复位。用户每次确认砝码已放稳后，才开始对应组的采集。

砝码由用户说明为标称 500 g、200 g、100 g；本次未取得其检定证书或以其他仪器复核实际质量。未记录环境温度、供电电压、秤盘具体安装状态和放置偏心量，因而本记录属于现有搭建状态下的**初步标定与线性检查**，不能据此宣称 0～20 kg 全量程精度。

操作顺序为：500 g → 空载 → 500 g 复放 → 加 200 g 得 700 g → 加 100 g 得 800 g → 只留 200 g + 100 g 得 300 g → 只留 200 g → 只留 100 g → 终点空载。各组原始数据分别保存在下列 CSV，列为 `timestamp_local,raw,net`，均保留实际采集行，未人工改写：

1. [首次 500 g，80 行](../原始数据/2026-10-15_标称500g砝码_加载实测.csv)
2. [中途空载，80 行](../原始数据/2026-10-15_标称500g砝码_卸载空载实测.csv)
3. [复放 500 g，80 行](../原始数据/2026-10-15_标称500g砝码_重复加载实测.csv)
4. [700 g，80 行](../原始数据/2026-10-15_标称700g砝码_加载实测.csv)
5. [800 g，80 行](../原始数据/2026-10-15_标称800g砝码_加载实测.csv)
6. [300 g，80 行](../原始数据/2026-10-15_标称300g砝码_卸载实测.csv)
7. [200 g，80 行](../原始数据/2026-10-15_标称200g砝码_卸载实测.csv)
8. [100 g，80 行](../原始数据/2026-10-15_标称100g砝码_加载实测.csv)
9. [终点空载，80 行](../原始数据/2026-10-15_多点试验_终点空载实测.csv)

首次 500 g 的前 **74 行**形成连续稳定段：`raw` 为 122425～122582，样本标准差 31.84 计数。最后 6 行（18:21:40.035～18:21:41.031）突然在 121205～129059 间波动，原因未确认，**不用于系数计算**，但仍完整保留在原 CSV。其余八组均用各自全部 80 行统计。所有 720 行的 `raw-net` 均为 **33854**，说明整段实验中固件所用的 `tare_offset` 保持 33854，`net` 仍是 ADC 计数而非克。

## 原始计数统计

样本标准差使用分母 `n-1`。下表的“估计质量”暂用后述系数和中途空载均值计算，未在固件内输出。

| 用户确认的载荷 | 统计行数 | `raw` 均值（计数） | `raw` 样本标准差（计数） | `raw` 范围 | 用初步系数估计（g） |
|---|---:|---:|---:|---:|---:|
| 首次 500 g，稳定段 | 74 | 122502.30 | 31.84 | 122425～122582 | 500.009 |
| 中途空载 | 80 | 33691.46 | 24.62 | 33632～33740 | 0（定义为本次参考零点） |
| 复放 500 g | 80 | 122499.15 | 28.44 | 122397～122589 | 499.992 |
| 700 g | 80 | 158009.49 | 30.57 | 157928～158075 | 699.916 |
| 800 g | 80 | 175770.41 | 28.52 | 175696～175846 | 799.911 |
| 300 g | 80 | 86928.09 | 26.95 | 86859～86978 | 299.725 |
| 200 g | 80 | 69161.85 | 24.79 | 69097～69223 | 199.700 |
| 100 g | 80 | 51377.36 | 23.29 | 51315～51430 | 99.572 |
| 终点空载 | 80 | 33583.70 | 25.37 | 33520～33637 | -0.607 |

## 初步换算系数与解释

以中途空载的 `raw` 均值 **33691.4625** 作为本次分析用零点；将首次 500 g 稳定段的 74 行和复放 500 g 的 80 行合并，其 `raw` 均值为 **122500.6623**。得到

```text
scale = (122500.6623 - 33691.4625) / 500 g
      = 177.6184 ADC计数/g
估计质量_g = (raw - 33691.4625) / 177.6184
```

这里 `offset` 是空载零点，用来扣除秤盘自重和电桥初始偏移；`scale` 是每克带来的计数变化，用来把扣零后的计数换算成克。砝码标称值参与了 500 g 系数计算，所以表中两组 500 g 接近 500 g 是**标定结果，不是独立精度验证**。700、800、300、200、100 g 是沿用该系数计算的多点检查；与标称值的差值依次约为 -0.084、-0.089、-0.275、-0.300、-0.428 g。这些是本次条件下的观测偏差，不能等同于仪器准确度指标。

两次 500 g 稳定段均值相差 **3.1473 计数**，在当前系数下相当于约 **0.018 g**，说明这两次放置结果接近；样本标准差约 23～32 计数对应的是短时读数波动，不是传感器的绝对误差。各次测量的加载方式和摆放位置没有量化，不能据此计算严格的重复性指标。

固件开机/按键去皮所得的 offset 是 **33854**，与本次中途空载均值相差 **162.5375 计数**，所以中途空载输出的 `net` 均值是 **-162.5375**，并非零。终点空载的 `raw` 均值又比中途空载低 **107.7625 计数**，用同一分析系数折算约 **-0.607 g**。这提示零点随时间、机械状态或实验操作发生了变化；本次没有同步测温、测电压，不能把它归因于温度。上述多点估计全部固定使用中途空载零点，**没有事后逐点调零或修正**。

## 可以写入论文的阶段性表述

在 STM32F103C8T6 与 HX711 构成的称重采集系统上，选用标称 100 g、200 g、500 g 砝码组合出 100、200、300、500、700、800 g 载荷，按“加载—卸载—重复加载”顺序记录串口输出，并分别保存每组 80 条带电脑接收时间戳的原始数据。500 g 首次采集末尾 6 条出现瞬态波动，统计时仅采用此前连续 74 条稳定读数，异常数据保留在原始文件中。以空载 `raw` 均值 33691.4625 和两组 500 g 稳定读数合并均值 122500.6623 计算，初步比例系数为 177.6184 计数/g。其余标称载荷按此系数换算，100～800 g 范围内本次观测值与标称值相差 -0.428～-0.084 g。试验终点空载均值比中途空载下降 107.7625 计数，表明在评价测量误差前，需要控制和记录零点随时间及机械安装状态的变化。由于砝码实际质量未独立核验，且尚未测量更高载荷，本次结果只作为初步功能与换算验证。

## 后续工作

在最终底盘和秤盘固定后重新进行空载去皮及已知质量标定；如要宣称 0～10 kg 范围的精度，需补充该范围内多个可信参考载荷，进行多次加载/卸载和不同位置试验，并记录温度、供电与实际质量。后续可将经复核的 `scale` 写入固件，输出 `g`，再验证滤波和温度补偿前后的误差。当前固件只输出 `raw/net`，尚未改为 `g`。
