Roxywwww/-/实验数据/阶段记录/2026-10-15_PA5按键去皮开发记录.md

# PA5 按键去皮开发记录

日期：2026-10-15  
阶段：按键去皮配置与固件编译；尚待实物按键验证

## 接线与 CubeMX 配置

按键一端接 PA5，另一端接 GND。`hx711test/hx711test.ioc` 中 PA5 原先未分配，现设为 `GPIO_Input`、`GPIO_PULLUP`，标签为 `TARE_BUTTON`。空闲时内部上拉使 PA5 为高电平，按下时接地为低电平。同步更新 `Core/Inc/main.h` 的引脚定义及 `Core/Src/main.c` 中的 GPIO 初始化，未改变 HX711 的 PB12/PB13、USART1 或时钟配置。

## 固件行为

- 保留原有开机空载去皮。
- 主循环约每 10 ms 检查 PA5；电平改变保持至少 30 ms 才作为稳定状态。每次稳定按下只触发一次，稳定松开后才允许下一次按下。
- 按键触发时读取 16 个 HX711 有效原始值，平均得到新 offset。读取超时或出现 HX711 饱和值时，输出失败提示并保留旧 offset。按键去皮不改变将来的标定系数 scale。
- 串口继续约每 200 ms 输出 `raw=... net=...`；成功按键去皮额外输出 `tare_button_offset=...`。`net` 仍是 ADC 计数，不是克。
- HX711 在 10 Hz 模式下一次转换约 100 ms，16 次去皮需要约 1.6 s 量级；实际时间随模块设置和读数等待而变。去皮过程有单次读取超时，不会无限等待 DOUT。

## 编译结果与未完成验证

Keil ARMCC V5.06 update 5 编译 `hx711test`：**0 Error(s), 0 Warning(s)**，已生成 HEX。没有把“编译通过”当作按键实物验证，也没有编造按键试验数据。

下一步应下载固件后测试：① 空载上电，确认开机 offset 和连续 raw/net；② 短按一次 PA5 按键，确认恰好出现一条 `tare_button_offset=...`；③ 按住不放时不应重复去皮；④ 松开再按可再次去皮；⑤ 在秤盘放物体后按键，松手后 net 应回到零附近；⑥ 拔掉 HX711 或让其异常时，按键去皮失败应保留旧 offset。实际串口数据和实测结果在测试后追加。

## 2026-10-15 串口实测追加

用户发送了连续 56 行串口文本，其中 53 行为 `raw/net`，3 行为按键去皮成功提示。逐行原文保存在 [PA5 按键去皮串口实测原文](../原始数据/2026-10-15_PA5按键去皮串口实测原文.txt)。采集期间的实际载荷状态、每次按键持续时间及逐条时间戳未说明，因此不能据此评价空载长期漂移、按住不重复触发或质量测量误差。

| 串口片段 | raw/net 行数 | `raw-net` 恒定值 | raw 平均值 | net 平均值 | net 范围 |
|---|---:|---:|---:|---:|---:|
| 首次按键提示前 | 12 | 32605 | 32703.25 | 98.25 | 59～132 |
| `tare_button_offset=32696` 后 | 12 | 32696 | 32705.50 | 9.50 | -52～96 |
| `tare_button_offset=32729` 后 | 4 | 32729 | 32770.50 | 41.50 | 35～49 |
| `tare_button_offset=32743` 后 | 25 | 32743 | 32767.96 | 24.96 | -22～69 |

每段的 `raw-net` 与当时的 offset 一致，表明新零点已应用于后续输出。按键去皮的 offset 来自按下后新读取的 **16 个 raw** 的平均值；这 16 个采样没有逐条通过串口输出，不能把按键提示前已打印的 raw/net 数据当作该平均值的输入。原先的 `net` 不参与新 offset 的计算。上述结果验证了三次新 offset 的应用，但尚未验证异常读取时保留旧 offset、按住不重复触发以及正式机械安装后的称重精度。
