Roxywwww/-/实验数据/阶段记录/2026-10-27_开题报告计划写法与目录整理记录.md

# 开题报告计划写法与目录整理记录

日期：2026-10-27。本阶段包含文档修订、文件归档、工程检查和GitHub同步准备，没有新增称重或温漂实验。

## 开题报告改为研究计划

根据使用者要求，开题报告以拟开展的研究内容、方法和进度安排为主。删除报告中的“已完成PCB”“程序已下载”“按键仍待验证”及具体标定系数、漂移量、滤波标准差和响应时间等阶段结果；相应实验记录与数据继续保留。背景部分改为一般研究问题，研究内容改为硬件设计、采集与显示程序、标定评价、滤波比较和温度补偿实验计划。时间安排同步改为计划描述。

采用的当前版本：

- [研究计划版Word](../../文档/开题报告/当前版本/基于STM32的电子秤设计与温度补偿研究_开题报告_研究计划版_2026-10-27.docx)
- [研究计划版Markdown](../../文档/开题报告/当前版本/开题报告_研究计划版_2026-10-27.md)

Word按4页导出并逐页检查，核对五栏结构、公式和参考文献。因原首轮Word当时被占用，另存研究计划版；目录整理时各文件已成功归档，没有删除原稿。

此前《2026-10-27_开题报告语言修订与引用核查记录》描述的是首轮修订，其中交付路径及正文实测结果的保留方式，以本次研究计划版和新目录为准。其文献核查结论继续适用；本次未新增AIGC或学校查重平台检测。

## 目录整理

- `hx711test`工程位置保留，工程源文件未因归档而移动。
- 开题报告分为`文档/开题报告/当前版本`与按日期组织的`历史版本`。
- 实验材料分为`实验数据/阶段记录`、`原始数据`和`图片`，并生成统一索引。
- 早期封装、参考图及嘉立创EDA历史工程分入`硬件资料`，明确资料版本用途。
- 器件安装包、临时渲染文件、日志与未确认来源的SQLite备份移入`本地工具`。该目录及`.workbuddy`本机记忆文件排除在Git提交之外。

本次移动87个文件，移动前后逐一比较SHA-256，均一致；随后仅更新Markdown中的48处相对链接。移动时没有文件因占用而保留重复副本。原始CSV、串口文本及图片内容未因整理而修改。完整移动清单与移动前哈希保存在本机`本地工具/目录整理清单_2026-10-27.json`。

## 整理后的验证

- 逐一校验39个原始数据与图片文件，SHA-256与整理前一致。
- 整理后首次检查117处相对链接，目标均在本机存在；随后把记录引用的历史Keil日志另存到`实验数据/构建日志`并更新对应链接，使其随仓库保留。
- 对当前`hx711test/MDK-ARM/hx711test.uvprojx`执行Keil编译，ARM Compiler V5.06 update 5返回0 errors、0 warnings；没有进行下载或重新去皮。[本次编译日志](../构建日志/2026-10-27_目录整理后编译.log)。
- GitHub同步前，远端`origin/main`与本地HEAD一致。已有PA3单位切换相关固件变更和此前暂存的试插记录一并纳入本次提交；本阶段没有改动固件逻辑。
- 原始数据与构建日志使用Git属性禁止换行转换，便于另一台电脑拉取后保留原始字节。历史日志中的工具输出空格按原样保留。

GitHub推送结果以实际命令结果及远端提交核对为准，提交代码不等同于硬件功能或精度验证。
