Roxywwww/-/实验数据/阶段记录/2026-10-27_开题报告语言修订与引用核查记录.md

# 开题报告语言修订与引用核查记录

日期：2026-10-27。工作性质：开题报告编辑与文献核查，不是新增称重、温度或电源实验。未修改固件、PCB或原始实验数据。

## 采用的最新原稿与交付

- 最新原稿：`基于STM32的电子秤设计与温度补偿研究_开题报告_2026-10-24.docx`，文件修改时间为2026-10-24 22:30:25；同时核对该日Markdown稿和HTML排版源文件。Word正文与该日Markdown主体内容一致。
- 新Word稿：`基于STM32的电子秤设计与温度补偿研究_开题报告_修订版_2026-10-27.docx`。
- 新纯文字稿：`开题报告_基于STM32的电子秤设计与温度补偿研究_修订版_2026-10-27.md`。
- 原稿保留。沿用题目、学生信息和学校表格的五栏结构。正文按第一至第四栏统计，约2900个非空白字符；第五栏参考文献另计。该口径不等同于学校平台的字数统计。

## 技能查找与使用范围

官方精选技能目录未提供可直接使用的中文论文降重工具。随后查阅第三方技能源码，安装并手动应用：

1. `zh-scientific-humanizer`：https://github.com/XuanjinZhu/zh-scientific-humanizer 。安装目录为`C:/Users/Roxy/.codex/skills/zh-scientific-humanizer`。应用中文科研润色、模板表达检查和证据强度规则，不调用其生物学专用术语分支。
2. `check-plagiarism`：https://github.com/vadym-khodak/researcher-skills/tree/main/skills/check-plagiarism 。安装目录为`C:/Users/Roxy/.codex/skills/check-plagiarism`。本次按引用审阅和文风审阅使用，检查来源错配、缺失引用及改述方式；其规则中的字词匹配阈值不作为中文论文查重标准。
3. Word编辑使用会话提供的`documents`技能。第三方技能均不能连接知网、维普、万方、Turnitin等学校或订阅数据库；本次未上传整篇报告到检测服务，未生成AIGC分数或重复率，不能报告下降百分比。

## 主要问题与修订

| 原稿问题 | 核查依据与处理 |
| --- | --- |
| 开头称200 g加载后原始计数从三万多到五万五千多 | 10月15日200 g组原始均值为69161.85计数；删除矛盾叙述，改用有记录的空载107.7625计数变化，约0.607 g。 |
| 换位置差值、空载二十分钟后上爬被写成既有实验 | 当前对应记录不足；删除这些具体经历，也不把漂移直接归因于模拟端或机械端。 |
| “不放大上千倍，ADC读不出细节” | 与现用A通道128倍设置及手册不符；改为说明芯片集成放大与转换，不给未经验证的放大倍数要求。 |
| “这一步不做完，后面的温漂数据没有意义”等绝对措辞 | 改为说明结构定型、受力路径和供电检查的用途；保留前期数据的初步验证价值。 |
| 将核心板插接载板写得接近重新设计最小系统 | 明确使用STM32核心板及HX711模块，载板负责接口连接与装配。 |
| 引入测温与完成补偿容易混淆 | 明确温度读取、显示、CRC已实现，正式温漂采集、建模和补偿验证尚待开展；PA3按键保留“已下载、待实物验证”。 |
| 工频抑制说明与技术路线脱节 | 增加芯片内部抑制、RATE核查与读取间隔的区别，不声称已经实现STM32软件陷波或实测过抑制量。 |
| 将空气温度视为完全无效，指定铝箔胶带贴近应变片 | 改为代表性测温、热接触和避开应变片/受力影响。保温箱方案标为探索，单点稳定判据标为初步判据。 |
| 温漂公式中零点与灵敏度符号含义不统一 | 统一使用R=b+k·m+ε；α为计数/℃，β为1/℃，并说明α/k₀可折为g/℃；Word中公式用可编辑数学对象。 |
| “硬件这边”“零点会跑”等表达偏口语 | 改成适合本科开题报告的平实学术表达，删除反复预告结构和装饰性结论。 |
| 前期波动改善可能被误认为准确度提高 | 保留0.156、0.154、0.087 g及0.806 s等数据，明确来自稳定组和一次动态过程，不能推广成最终精度。 |

## 参考文献核查

1. HX711改用AVIA原厂V2.0手册，未沿用未核实的“Rev. A/B，2012”版本信息。原厂文件由TI论坛托管不表示HX711由TI制造： https://e2e.ti.com/cfs-file/__key/communityserver-discussions-components-files/73/HX711.pdf 。
2. 新增ST官方STM32F103x8/xB数据手册DS5319 Rev 20，手册首页标注July 2025： https://www.st.com/resource/en/datasheet/stm32f103t8.pdf 。
3. DS18B20原稿标题中的“Resolver”改成官方“Resolution”，核对Rev 6、2019年7月： https://www.analog.com/media/en/technical-documentation/data-sheets/ds18b20.pdf 。
4. 原稿AMS1117条目把制造商写成TI，且尚未确认实物核心板所用稳压器，不继续引用。没有据此更换硬件或认定实际芯片型号。
5. 原稿“王国旗、张立军，称重传感器温漂机理及温度补偿方法综述，计量技术，2020(4):45-49”暂未查得足以核实的来源，移出参考文献。这里只标为未核实，不断言文献不存在。替换为Zhuang等2024年原始研究，作者、题目、卷号14、文章号26213与DOI均按期刊页面核对： https://www.nature.com/articles/s41598-024-76688-0 。正文只使用温度场及补偿位置会影响结果的结论，不声称本样机已复现其方案。
6. 原稿“ISO 7634:1984 国际建议 数字指示秤”编号与主题错配。ISO目录中的7634属于道路车辆压缩空气制动系统范畴： https://www.iso.org/committee/46706/x/catalogue/ 。替换为OIML R 60-1:2021，标题与版本由官方文件核实： https://www.oiml.org/en/files/pdf_r/r060-1-e21.pdf 。
7. JJG 539—2016保留，发布机构更正为国家质量监督检验检疫总局；标题页公开扫描核对地址： https://img.antpedia.com/standard/files/pdfs_ora/20230331/JJG%20539-2016.PDF 。该公开文件仅有前三页，不能据此宣称已逐条审阅完整检定要求；报告仅参考项目组织，不作符合性检定结论。

## 字面相似、引用及真实性检查的边界

- 本次进行了文风和引用审阅，并对技术背景使用独立表述加来源标注。没有进行学校数据库全文比对，不能据此证明“无抄袭”或“低于某百分比”。
- 前期实验数字与已有原始记录相同是正常的数据复用，不为降低文字匹配而修改数字、单位、器件名或标准名。
- 对照了既有标定、滤波、DS18B20及PA3开发记录，区分已完成和计划工作；没有添加温漂实测系数、补偿改善率或新砝码数据。
- 规范名称、器件术语、公式和参考文献可能在相似性报告中匹配，应按学校规则处理，不为规避匹配而扭曲术语或删去引用。

## Word验证

以bundled Python的python-docx生成独立修订文件；尝试运行documents技能的render_docx.py，日志提示本机PATH无LibreOffice soffice.exe。随后用本机WPS自动化只读打开修订稿并导出PDF，再用Poppler生成逐页PNG检查。预览为4页。检查内容包括五栏标题、正文、引用、六条文献及数学公式；预览文件仅用于排版核查，不作为新增交付的实验材料。

后续若取得学校平台的检测报告，可根据实际标出的重复段落、来源及排除规则再做针对性修订；本记录不虚构检测结果。
