Roxywwww/-/实验数据/图片/2026-10-13_HX711排查图片/商家接线示意.jpg

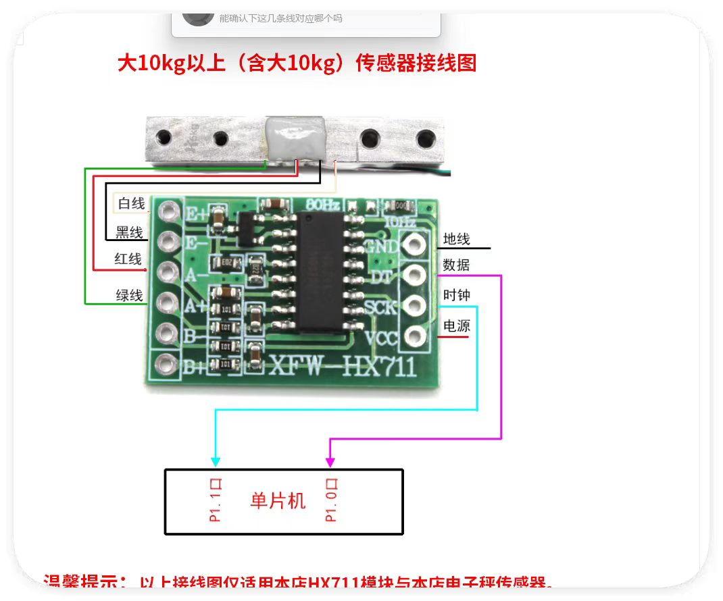
实验数据/图片/2026-10-13_HX711排查图片/商家接线示意.jpg
