Roxywwww/-/实验数据/图片/2026-10-23_HX711纸样试插图片/试插_斜上视角.jpg

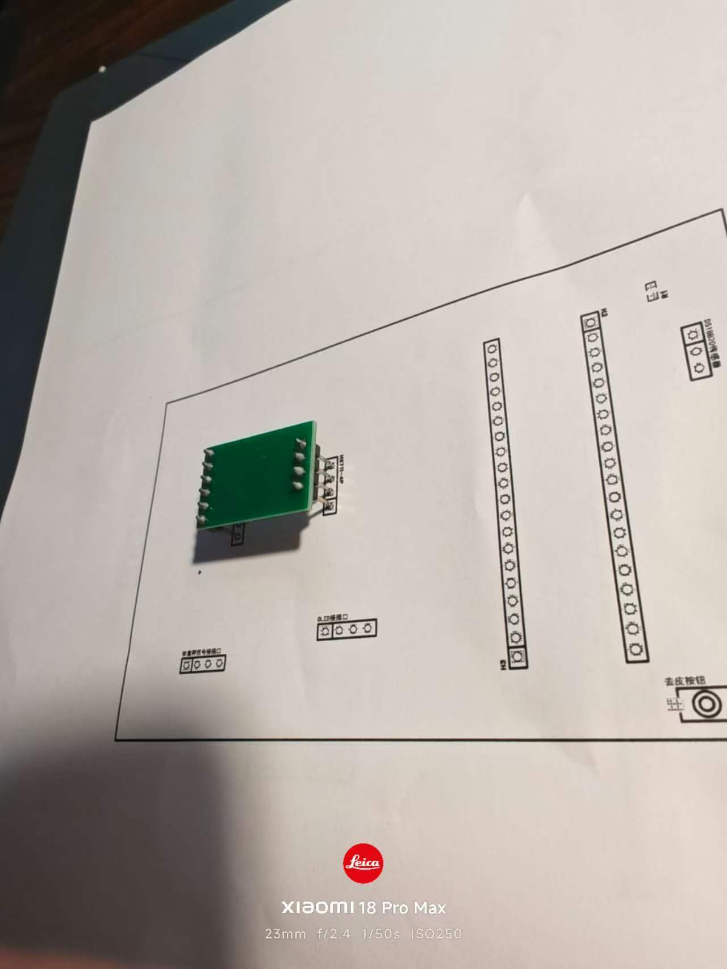
实验数据/图片/2026-10-23_HX711纸样试插图片/试插_斜上视角.jpg
