Roxywwww/-/实验数据/图片/STM32排距标注检查.png

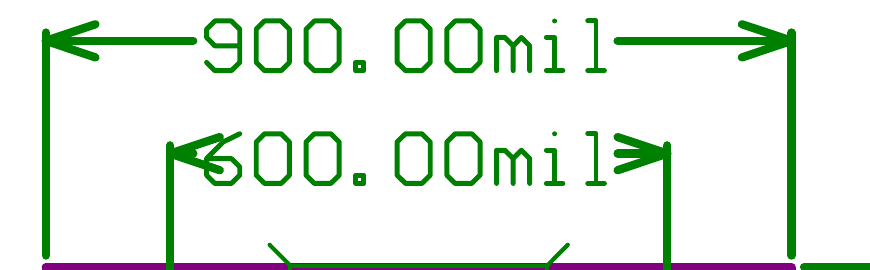
实验数据/图片/STM32排距标注检查.png
