Roxywwww/-/实验数据/图片/STM32核心板尺寸参考.png

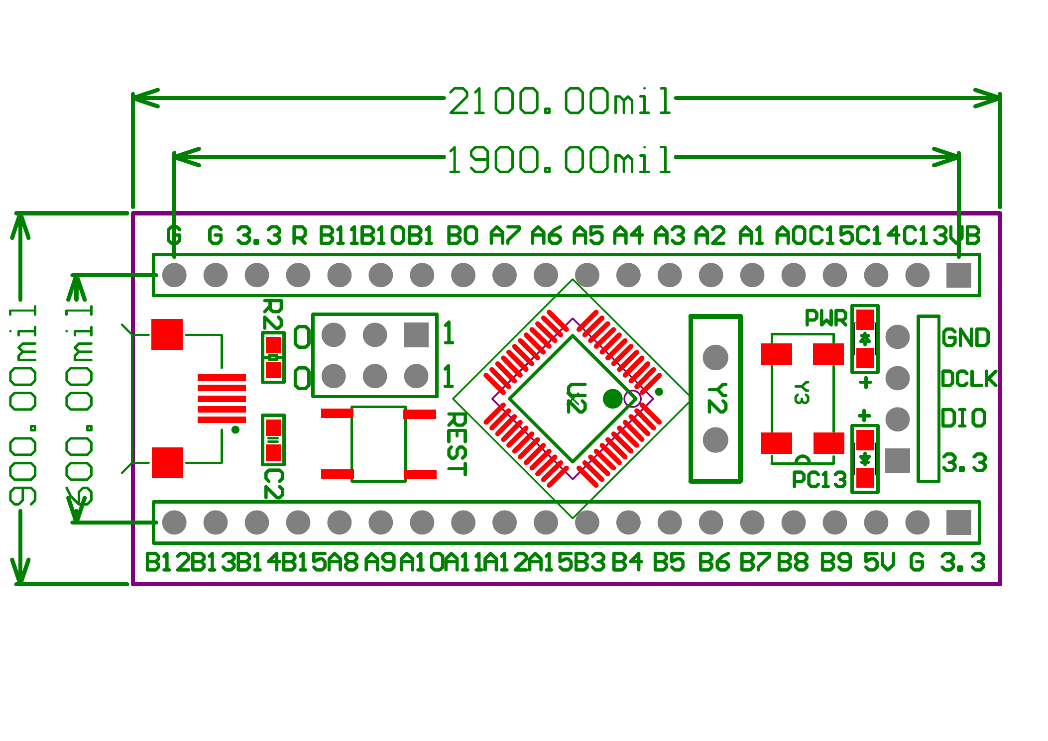
实验数据/图片/STM32核心板尺寸参考.png
