Roxywwww/-/硬件资料/参考图/hx711_reference_schematic.png

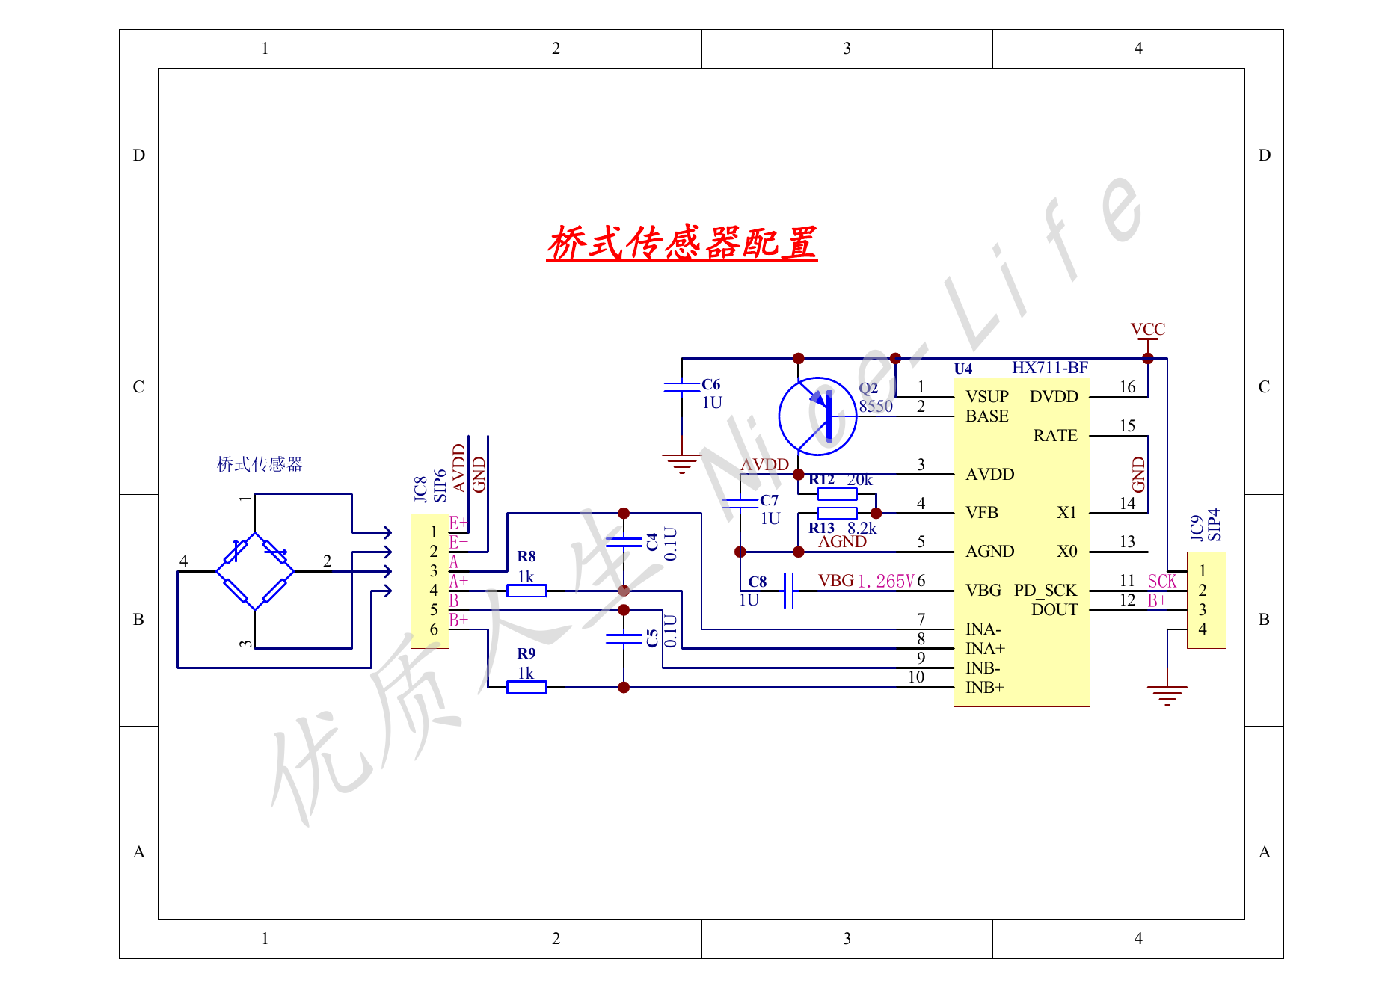
硬件资料/参考图/hx711_reference_schematic.png
