Roxywwww/-/hx711test/Core/Src/main.c

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
/* Includes ------------------------------------------------------------------*/
#include "main.h"

/* USER CODE BEGIN Includes */
#include <stdio.h>
#include "hx711.h"
#include "oled.h"
#include "ds18b20.h"

/* USER CODE END Includes */

/* USER CODE BEGIN PD */
#define HX711_TARE_SAMPLES 16U
#define TARE_BUTTON_DEBOUNCE_MS 30U
#define UNIT_BUTTON_DEBOUNCE_MS 30U
#define RAW_REPORT_INTERVAL_MS 200U
#define HX711_AVERAGE_SAMPLES 5U
#define OLED_REPORT_INTERVAL_MS 500U
#define DS18B20_CONVERSION_MS 800U
#define DS18B20_RETRY_MS 1000U
/* 500 g calibration on 2026-10-15: 177.6184 ADC counts per gram. */
#define HX711_COUNTS_PER_GRAM_X10000 1776184LL

/* USER CODE END PD */

UART_HandleTypeDef huart1;

/* USER CODE BEGIN PV */
static const uint8_t startup_message[] = "USART1 OK, 115200 8N1\r\n";
static int32_t tare_offset;
static uint8_t tare_valid;
static int32_t average_samples[HX711_AVERAGE_SAMPLES];
static int64_t average_sum;
static uint8_t average_count;
static uint8_t average_index;
static uint32_t last_oled_tick;
static uint32_t temperature_tick;
static uint8_t temperature_converting;
static uint8_t display_unit_kg;

/* USER CODE END PV */

void SystemClock_Config(void);
static void MX_GPIO_Init(void);
static void MX_USART1_UART_Init(void);
/* USER CODE BEGIN 0 */
static HAL_StatusTypeDef HX711_Tare(int32_t *new_offset)
{
  int64_t sum = 0;
  uint8_t count;
  int32_t sample;
  HAL_StatusTypeDef status;

  for (count = 0U; count < HX711_TARE_SAMPLES; ++count)
  {
    status = HX711_Read(&sample, 200U);
    if (status != HAL_OK)
    {
      return status;
    }
    if (sample == -8388608L || sample == 8388607L)
    {
      return HAL_ERROR;
    }
    sum += sample;
  }

  *new_offset = (int32_t)(sum / HX711_TARE_SAMPLES);
  return HAL_OK;
}

/* Return weight in 0.1 g units; round signed values symmetrically.
   The 64-bit product avoids overflow at the HX711's 24-bit limits. */
static int32_t HX711_NetToTenthsOfGram(int32_t net)
{
  int64_t magnitude = (net < 0) ? -(int64_t)net : (int64_t)net;
  int32_t tenths = (int32_t)((magnitude * 100000LL +
                              HX711_COUNTS_PER_GRAM_X10000 / 2LL) /
                             HX711_COUNTS_PER_GRAM_X10000);

  return (net < 0) ? -tenths : tenths;
}

static void HX711_AverageReset(void)
{
  average_sum = 0;
  average_count = 0U;
  average_index = 0U;
}

/* Average the newest five net readings, or all available readings at start. */
static int32_t HX711_AverageAdd(int32_t net)
{
  if (average_count == HX711_AVERAGE_SAMPLES)
  {
    average_sum -= average_samples[average_index];
  }
  else
  {
    ++average_count;
  }

  average_samples[average_index] = net;
  average_sum += net;
  average_index = (uint8_t)((average_index + 1U) % HX711_AVERAGE_SAMPLES);

  return (int32_t)(average_sum / average_count);
}

/* Keep the whole display row 16 characters long so old digits are erased. */
static void OLED_ShowWeightTenths(int32_t tenths)
{
  char display_line[17];
  uint32_t magnitude = (tenths < 0) ? (uint32_t)(-tenths) :
                                       (uint32_t)tenths;
  int length;

  if (display_unit_kg != 0U)
  {
    /* tenths of a gram are ten-thousandths of a kilogram. */
    length = snprintf(display_line, sizeof(display_line),
                      "K %s%lu.%04lu kg", (tenths < 0) ? "-" : "",
                      (unsigned long)(magnitude / 10000U),
                      (unsigned long)(magnitude % 10000U));
  }
  else
  {
    length = snprintf(display_line, sizeof(display_line),
                      "G %s%lu.%01lu g", (tenths < 0) ? "-" : "",
                      (unsigned long)(magnitude / 10U),
                      (unsigned long)(magnitude % 10U));
  }

  if (length < 0 || length > 16)
  {
    return;
  }
  while (length < 16)
  {
    display_line[length++] = ' ';
  }
  display_line[16] = '\0';
  OLED_ShowString(2U, 1U, display_line);
}

static void DS18B20_Service(void)
{
  uint32_t now = HAL_GetTick();
  int16_t centi;
  char line[32];
  char display_line[17];
  int length;

  if ((now - temperature_tick) <
      (temperature_converting != 0U ? DS18B20_CONVERSION_MS : DS18B20_RETRY_MS))
  {
    return;
  }

  if (temperature_converting != 0U)
  {
    if (DS18B20_ReadCentiC(&centi) == HAL_OK)
    {
      uint32_t magnitude = (centi < 0) ? (uint32_t)(-(int32_t)centi) :
                                          (uint32_t)centi;
      length = snprintf(line, sizeof(line), "temp_c=%s%lu.%02lu\r\n",
                        (centi < 0) ? "-" : "",
                        (unsigned long)(magnitude / 100U),
                        (unsigned long)(magnitude % 100U));
      if (length > 0 && length < (int)sizeof(line))
      {
        HAL_UART_Transmit(&huart1, (uint8_t *)line, (uint16_t)length, 100U);
      }

      length = snprintf(display_line, sizeof(display_line),
                        "T %s%lu.%02lu C", (centi < 0) ? "-" : "",
                        (unsigned long)(magnitude / 100U),
                        (unsigned long)(magnitude % 100U));
      if (length > 0 && length <= 16)
      {
        while (length < 16)
        {
          display_line[length++] = ' ';
        }
        display_line[16] = '\0';
        OLED_ShowString(3U, 1U, display_line);
      }
    }
    else
    {
      static const uint8_t error_message[] = "temp_error=read_or_crc\r\n";
      HAL_UART_Transmit(&huart1, (uint8_t *)error_message,
                        sizeof(error_message) - 1U, 100U);
      OLED_ShowString(3U, 1U, "TEMP ERROR      ");
    }
  }

  temperature_converting = (DS18B20_StartConversion() == HAL_OK) ? 1U : 0U;
  temperature_tick = HAL_GetTick();
  if (temperature_converting == 0U)
  {
    static const uint8_t missing_message[] = "temp_error=no_presence\r\n";
    HAL_UART_Transmit(&huart1, (uint8_t *)missing_message,
                      sizeof(missing_message) - 1U, 100U);
    OLED_ShowString(3U, 1U, "TEMP ERROR      ");
  }
}

/* USER CODE END 0 */

/**
  * @brief  The application entry point.
  * @retval int
  */
int main(void)
{

  /* USER CODE BEGIN 1 */
  GPIO_PinState button_last_sample;
  GPIO_PinState button_stable_state;
  uint32_t button_change_tick;
  uint32_t last_report_tick;
  uint8_t button_armed;
  GPIO_PinState unit_last_sample;
  GPIO_PinState unit_stable_state;
  uint32_t unit_change_tick;
  uint8_t unit_armed;

  /* USER CODE END 1 */

  /* MCU Configuration--------------------------------------------------------*/

  /* Reset of all peripherals, Initializes the Flash interface and the Systick. */
  HAL_Init();

  /* Configure the system clock */
  SystemClock_Config();

  /* Initialize all configured peripherals */
  MX_GPIO_Init();
  MX_USART1_UART_Init();
  /* USER CODE BEGIN 2 */
  HAL_UART_Transmit(&huart1, (uint8_t *)startup_message,
                    sizeof(startup_message) - 1U, 100U);
  OLED_Init();
  OLED_ShowString(1U, 1U, "WEIGHT (g)");
  OLED_ShowString(2U, 1U, "Waiting HX711...");
  OLED_ShowString(3U, 1U, "TEMP WAIT");
  OLED_ShowString(4U, 1U, "PA5 TARE A3 UNIT");
  DS18B20_Init();
  temperature_converting = (DS18B20_StartConversion() == HAL_OK) ? 1U : 0U;
  temperature_tick = HAL_GetTick();
  HAL_Delay(500U);

  /* The pan must be empty at startup. Average several conversions for zero. */
  {
    int32_t new_offset;
    char line[64];
    int length;

    if (HX711_Tare(&new_offset) == HAL_OK)
    {
      tare_offset = new_offset;
      tare_valid = 1U;
      HX711_AverageReset();
      length = snprintf(line, sizeof(line), "tare_offset=%ld samples=%u\r\n",
                        (long)tare_offset, (unsigned int)HX711_TARE_SAMPLES);
    }
    else
    {
      length = snprintf(line, sizeof(line),
                        "tare failed; keep pan empty and reset\r\n");
    }

    if (length > 0 && length < (int)sizeof(line))
    {
      HAL_UART_Transmit(&huart1, (uint8_t *)line, (uint16_t)length, 100U);
    }
  }

  button_last_sample = HAL_GPIO_ReadPin(TARE_BUTTON_GPIO_Port, TARE_BUTTON_Pin);
  button_stable_state = button_last_sample;
  button_change_tick = HAL_GetTick();
  button_armed = (button_stable_state == GPIO_PIN_SET) ? 1U : 0U;
  unit_last_sample = HAL_GPIO_ReadPin(UNIT_BUTTON_GPIO_Port, UNIT_BUTTON_Pin);
  unit_stable_state = unit_last_sample;
  unit_change_tick = HAL_GetTick();
  unit_armed = (unit_stable_state == GPIO_PIN_SET) ? 1U : 0U;
  last_report_tick = HAL_GetTick() - RAW_REPORT_INTERVAL_MS;
  last_oled_tick = HAL_GetTick() - OLED_REPORT_INTERVAL_MS;

  /* USER CODE END 2 */

  /* Infinite loop */
  /* USER CODE BEGIN WHILE */
  while (1)
  {
    /* USER CODE END WHILE */

    /* USER CODE BEGIN 3 */
    int32_t raw;
    char line[64];
    int length;
    uint32_t now = HAL_GetTick();
    GPIO_PinState button_sample = HAL_GPIO_ReadPin(TARE_BUTTON_GPIO_Port,
                                                    TARE_BUTTON_Pin);

    /* Accept a change only after it remains unchanged for the debounce time. */
    if (button_sample != button_last_sample)
    {
      button_last_sample = button_sample;
      button_change_tick = now;
    }
    if (button_last_sample != button_stable_state &&
        (now - button_change_tick) >= TARE_BUTTON_DEBOUNCE_MS)
    {
      button_stable_state = button_last_sample;
      if (button_stable_state == GPIO_PIN_SET)
      {
        button_armed = 1U;
      }
      else if (button_armed != 0U)
      {
        int32_t new_offset;
        /* A held button cannot start a second tare until it is released. */
        button_armed = 0U;

        if (HX711_Tare(&new_offset) == HAL_OK)
        {
          tare_offset = new_offset;
          tare_valid = 1U;
          HX711_AverageReset();
          length = snprintf(line, sizeof(line), "tare_button_offset=%ld\r\n",
                            (long)tare_offset);
        }
        else
        {
          length = snprintf(line, sizeof(line),
                            "tare button failed; old offset kept\r\n");
        }

        if (length > 0 && length < (int)sizeof(line))
        {
          HAL_UART_Transmit(&huart1, (uint8_t *)line, (uint16_t)length, 100U);
        }
      }
    }

    /* Change display units once per debounced press; tare/calibration stay intact. */
    {
      GPIO_PinState unit_sample = HAL_GPIO_ReadPin(UNIT_BUTTON_GPIO_Port,
                                                   UNIT_BUTTON_Pin);
      if (unit_sample != unit_last_sample)
      {
        unit_last_sample = unit_sample;
        unit_change_tick = HAL_GetTick();
      }
      if (unit_last_sample != unit_stable_state &&
          (HAL_GetTick() - unit_change_tick) >= UNIT_BUTTON_DEBOUNCE_MS)
      {
        unit_stable_state = unit_last_sample;
        if (unit_stable_state == GPIO_PIN_SET)
        {
          unit_armed = 1U;
        }
        else if (unit_armed != 0U)
        {
          static const uint8_t unit_g_message[] = "display_unit=g\r\n";
          static const uint8_t unit_kg_message[] = "display_unit=kg\r\n";
          unit_armed = 0U;
          display_unit_kg ^= 1U;
          OLED_ShowString(1U, 1U,
                          display_unit_kg != 0U ? "WEIGHT (kg)" : "WEIGHT (g) ");
          last_oled_tick = HAL_GetTick() - OLED_REPORT_INTERVAL_MS;
          if (display_unit_kg != 0U)
          {
            HAL_UART_Transmit(&huart1, (uint8_t *)unit_kg_message,
                              sizeof(unit_kg_message) - 1U, 100U);
          }
          else
          {
            HAL_UART_Transmit(&huart1, (uint8_t *)unit_g_message,
                              sizeof(unit_g_message) - 1U, 100U);
          }
        }
      }
    }

    /* Keep serial reports spaced out while checking the button every 10 ms. */
    if ((HAL_GetTick() - last_report_tick) >= RAW_REPORT_INTERVAL_MS)
    {
      HAL_StatusTypeDef status;
      last_report_tick = HAL_GetTick();
      status = HX711_Read(&raw, 200U);

      if (status == HAL_OK)
      {
        if (tare_valid != 0U)
        {
          int32_t net = raw - tare_offset;
          int32_t tenths = HX711_NetToTenthsOfGram(net);
          int32_t average_net = HX711_AverageAdd(net);
          int32_t average_tenths = HX711_NetToTenthsOfGram(average_net);
          uint32_t magnitude = (tenths < 0) ? (uint32_t)(-tenths) :
                                               (uint32_t)tenths;
          uint32_t average_magnitude = (average_tenths < 0) ?
                                       (uint32_t)(-average_tenths) :
                                       (uint32_t)average_tenths;

          if ((HAL_GetTick() - last_oled_tick) >= OLED_REPORT_INTERVAL_MS)
          {
            OLED_ShowWeightTenths(average_tenths);
            last_oled_tick = HAL_GetTick();
          }

          length = snprintf(line, sizeof(line),
                            "raw=%ld net=%ld g=%s%lu.%01lu g_avg=%s%lu.%01lu\r\n",
                            (long)raw, (long)net,
                            (tenths < 0) ? "-" : "",
                            (unsigned long)(magnitude / 10U),
                            (unsigned long)(magnitude % 10U),
                            (average_tenths < 0) ? "-" : "",
                            (unsigned long)(average_magnitude / 10U),
                            (unsigned long)(average_magnitude % 10U));
        }
        else
        {
          length = snprintf(line, sizeof(line), "raw=%ld tare=invalid\r\n",
                            (long)raw);
        }
      }
      else
      {
        length = snprintf(line, sizeof(line), "HX711 timeout\r\n");
      }

      if (length > 0 && length < (int)sizeof(line))
      {
        HAL_UART_Transmit(&huart1, (uint8_t *)line, (uint16_t)length, 100U);
      }
    }
    DS18B20_Service();
    HAL_Delay(10U);
  }
  /* USER CODE END 3 */
}

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
