Roxywwww/-/hx711test/Core/Inc/main.h

#define HX711_SCK_Pin GPIO_PIN_12
#define HX711_SCK_GPIO_Port GPIOB
#define HX711_DOUT_Pin GPIO_PIN_13
#define HX711_DOUT_GPIO_Port GPIOB
#define OLED_SCL_Pin GPIO_PIN_8
#define OLED_SCL_GPIO_Port GPIOB
#define OLED_SDA_Pin GPIO_PIN_9
#define OLED_SDA_GPIO_Port GPIOB
#define TARE_BUTTON_Pin GPIO_PIN_5
#define TARE_BUTTON_GPIO_Port GPIOA
#define UNIT_BUTTON_Pin GPIO_PIN_3
#define UNIT_BUTTON_GPIO_Port GPIOA
#define DS18B20_DQ_Pin GPIO_PIN_12
#define DS18B20_DQ_GPIO_Port GPIOA
