Roxywwww/-/(commit log)

2026-10-23 初始化: 基于STM32的电子秤设计与温度补偿研究
    [2026-10-15_5点滑动平均_500g卸载动态实测.csv, 2026-10-15_5点滑动平均_500g稳定实测.csv, 2026-10-15_5点滑动平均_空载实测.csv, 2026-10-15_克数固件_100g实测.csv, 2026-10-15_克数固件_500g实测.csv, 2026-10-15_克数固件_800g实测.csv, 2026-10-15_克数固件_按键去皮后空载实测.csv, 2026-10-15_克数固件_空载实测.csv]
2026-10-27 整理毕设目录并更新开题研究计划与阶段记录
    [2026-10-15_5点滑动平均_500g卸载动态实测.csv, 2026-10-15_5点滑动平均_500g稳定实测.csv, 2026-10-15_5点滑动平均_空载实测.csv, 2026-10-15_克数固件_100g实测.csv, 2026-10-15_克数固件_500g实测.csv, 2026-10-15_克数固件_800g实测.csv, 2026-10-15_克数固件_按键去皮后空载实测.csv, 2026-10-15_克数固件_空载实测.csv]
2026-10-27 核对知网参考文献示例并统一开题报告文献排版
